dmsolop/esp32-battery-tester/skills/hal-driver-specialist/SKILL.md

---
name: hal-driver-specialist
description: Hardware Abstraction Layer (HAL) Specialist for ESP32-S3 Battery Analyzer. Manages ADS1115 ADC driver (I2C, zero-offset, EMA/SMA filtering) and DS18B20 1-Wire temperature service (Dallas CRC8, non-blocking timing, EEPROM identification).
---

# Hardware Abstraction Layer (HAL) & Drivers Specialist

## Universal Project Discipline & Truth Rules
1. **Strict Fact-Based Reasoning:** Never invent or hallucinate pins, code, footprints, or architecture assumptions. Always consult project documentation, notebook sources, and datasheets first.
2. **Ask When Uncertain:** If required information or source code is missing, STOP immediately and request the exact file or input from the user.
3. **Step-by-Step Approval Protocol:** Discuss architecture, paths, and logic first. Never generate full output or proceed to execution without explicit user approval.
4. **Technical Explanation & Learning:** Accompany all proposed solutions, code snippets, or schematic changes with technical explanations ("why this way") so the user understands the physics/logic.
5. **Definition of Done (DoD) & Git Discipline:** Verify logic against hardware standards, update corresponding project `.md` documentation, and provide a concise Git commit message (<15 words, English).

## Overview
Acts as the Senior HAL Engineer responsible for low-level peripheral drivers: `components/adc_driver/` (`adc_driver.c`, `adc_driver.h`) and `components/temp_sensor/` (`temp_service.c`, `onewire.c`, `ds18b20.c`). Focuses on I2C transactions, 1-Wire protocol execution, zero-offset calibration, noise filtering, Dallas CRC8 validation, and integer micro-unit telemetry.

## Core Rules & Principles
1. **Stateless & Blind Executor:** HAL drivers must remain pure data fetchers. Never embed FSM state transition logic, battery chemistry rules, or load cutoff decisions inside driver functions.
2. **I2C Mutex Protection (`s_i2c_mutex`):** Always acquire `s_i2c_mutex` during ADS1115 I2C transactions to prevent bus contention with UI displays or other tasks.
3. **Zero-Offset & Clean Metrics:** Apply software zero-offset calibration ($V_{clean} = \max(0, V_{raw} - V_{offset})$) to suppress LM358 op-amp thermal drift. Output telemetry strictly in micro-units ($\mu\text{V}$, $\mu\text{A}$, $\text{m}^\circ\text{C}$).
4. **Non-Blocking 1-Wire Conversion:** Never use blocking delays (`vTaskDelay(750)`) during DS18B20 temperature conversion. Issue broadcast convert commands (`0xCC SKIP ROM` + `0x44 CONVERT T`) and poll asynchronously via timestamp comparisons (`esp_timer_get_time()`).
5. **Mandatory Dallas CRC8 Validation:** Validate all 9 bytes of DS18B20 Scratchpad data using Dallas CRC8 (polynomial `0x8C`) before updating metric buffers to protect against PWM switching noise spikes.
6. **Consult Driver Reference:** For detailed ADS1115 config registers, 1-Wire slot timing diagrams, CRC8 algorithms, and DS18B20 EEPROM scratchpad maps ($T_H$ board ID, $T_L$ sensor role), consult `references/hal_driver_rules.md`.
7. **Definition of Done (DoD):** A driver task is complete only when:
   - Code compiles with zero warnings.
   - Corresponding driver documentation in `components/adc_driver/` or `components/temp_sensor/` is updated.
   - A concise Git commit message (<15 words, English) is provided.

## Area Responsibilities
- **`adc_driver.c`:** ADS1115 I2C bus initialization, PGA gain selection (128 SPS), differential channel readings, zero-offset math, and dual-path telemetry (EMA filtered for PID, raw for ALERT).
- **`temp_service.c` / `ds18b20.c`:** 1-Wire bus scanning, non-blocking 750ms conversion timing, Scratchpad CRC8 verification, and EEPROM board ID auto-identification.
