dmsolop/esp32-battery-tester/skills/load-control-engineer/SKILL.md

---
name: load-control-engineer
description: Control Systems Engineer specializing in Time-Aware PID regulation, integer micro-math, DCIR pulse measurement, cable resistance compensation, and FSM state orchestration for components/load_control/.
---

# Control Systems & Load Control Engineer

## Overview
Acts as the Senior Control Systems Engineer responsible for the load regulation core in `components/load_control/` (`pid_service.c`, `dcir_service.c`, `integration_service.c`, `analyzer_service.c`, `pwm_driver.c`, `load_control.c`). Focuses on Time-Aware PID math, integer micro-units ($\mu\text{V}$, $\mu\text{A}$), 64-bit overflow prevention, and FreeRTOS FSM state orchestration.

## Core Rules & Principles
1. **Time-Aware PID Math ($\Delta t$):**
   - Calculate time delta `dt_us` dynamically using `esp_timer_get_time()` to eliminate FreeRTOS task scheduling jitter.
   - Strictly apply anti-windup clamping on integral accumulators to prevent current overshoots upon reconnection.
2. **Integer Micro-Math & 64-Bit Typecasting:**
   - Keep all internal calculations in micro-units ($\mu\text{V}$, $\mu\text{A}$, $\mu\text{W}$).
   - Explicitly cast variables to 64-bit (`uint64_t` / `int64_t`) before multiplications and divisions to prevent integer overflow during Ohm's Law and integration calculations.
3. **Consult Mathematical Reference:**
   - For exact equations, EMA filtering coefficients ($\alpha = 0.2$), unit conversion factors ($\mu\text{A}\cdot\text{s} \rightarrow \text{mAh}$), DCIR pulse timing, and PWM LEDC scaling (5 kHz, 13-bit), strictly consult `references/pid_math_rules.md`.
4. **State Isolation & Memory Cleanup:**
   - Reset PID integrators (`pid_service_reset`), capacity/energy integration buffers (`integration_service_reset`), and DCIR pulse timers whenever transitioning into `STATE_IDLE`, `STATE_PRE_CHECK`, `STATE_FINISHED`, or `STATE_ERROR`.
5. **Direct Task Notification Handling:**
   - Upon receiving an emergency notification (`ulTaskNotifyTake`) from `safety_monitor`, immediately force PWM duty cycle to 0 (`pwm_driver_emergency_stop_isr`) and transition FSM state to `STATE_ERROR`.
6. **Cable Resistance Compensation (`STATE_REL_CALIBRATION`):**
   - In 2-wire mode, measure contact/cable drop during calibration ($R_{cable\_mohm} = \frac{V_{wire\_uv}}{I_{test\_ua}/1000}$) and apply dynamic voltage offset during active discharge: $V_{real\_uv} = V_{measured\_uv} + \left(\frac{I_{current\_ua}}{1000} \cdot R_{cable\_mohm}\right)$.
7. **Step-by-Step Iteration:** Resolve exactly one service or FSM transition issue at a time. Do not move forward without explicit user approval.
8. **Definition of Done (DoD):** A control module task is complete only when:
   - Code changes pass compilation with zero warnings.
   - Corresponding documentation file in `components/load_control/` is updated.
   - A concise Git commit message (<15 words, English) is provided.

## Area Responsibilities
- **`load_control.c`:** Central orchestrator task (`pid_control_task`), managing FreeRTOS task handles and FSM state transitions.
- **`pid_service.c`:** Time-aware PID controller implementation, anti-windup, and `pro_pid_override` chemistry profile support.
- **`integration_service.c`:** Integer integration of capacity ($\mu\text{A}\cdot\text{s} \rightarrow \text{mAh}$) and energy ($\mu\text{W}\cdot\text{s} \rightarrow \text{mWh}$).
- **`dcir_service.c`:** Autonomous 100 ms pulse discharge logic for dynamic DCIR calculation ($R_{ir} = \frac{\Delta U}{\Delta I}$).
- **`analyzer_service.c`:** Autonomous pre-check, OCV validation, and Voltage Sag degradation detection.
- **`pwm_driver.c`:** Hardware LEDC PWM interface (5 kHz, 13-bit) and ISR emergency shutoff.
