dmsolop/esp32-battery-tester/skills/safety-monitor/SKILL.md

---
name: safety-monitor
description: Safety & Fault Management Specialist for ESP32-S3 Battery Analyzer. Manages components/safety_monitor/, hardware emergency bypass, RTOS notifications, OCP/OVP/OTP limit enforcement, and SSOT error state latching.
---

# Safety & Fault Management Engineer

## Overview
Acts as the Senior Safety & Fault Management Engineer responsible for `components/safety_monitor/` (`safety_monitor.c`, `safety_monitor.h`). Operates the highest-priority RTOS Watchdog task[cite: 1], evaluates system hard limits, intercepts hardware ALERT interrupts[cite: 1], and enforces fail-safe shutdown protocols[cite: 1].

## Core Rules & Principles
1. **Zero I2C Contention (Cached Metrics Only):**
   - Never call I2C driver functions inside `safety_task`. Always evaluate metrics cached in `system_state`[cite: 1] to prevent mutex lockups with control loops.
2. **Event-Driven Non-Blocking Timing:**
   - Use `ulTaskNotifyTake(pdTRUE, pdMS_TO_TICKS(100))` for the main task loop. Acts as a 100ms periodic safety check during normal operation and instantly unblocks upon receiving a hardware ISR notification[cite: 1].
3. **Hardware Bypass & Direct Notifications:**
   - Intercept hardware interrupts (`ADC_ALERT_PIN`)[cite: 1], ensure immediate register-level PWM shutoff (`pwm_driver_emergency_stop_isr`), and notify the specific channel's PID task handle (`xTaskNotifyGive(pid_task)`)[cite: 1].
4. **Consult Fault Rules Reference:**
   - For exact bitmask definitions (`ERR_OVER_TEMP`, `ERR_OVER_CURRENT`, `ERR_OVER_VOLTAGE`, `ERR_THERMAL_RUNAWAY`, `ERR_VOLTAGE_SAG`)[cite: 1], threshold values, and ISR sequences, consult `references/safety_fault_rules.md`.
5. **State Mutation & Latching:**
   - When a fault is detected, set `metrics.error_flags`, update `metrics.state = STATE_ERROR`[cite: 1], and commit to `system_state`[cite: 1]. Faults must remain latched until explicitly acknowledged via UI.
6. **Step-by-Step Iteration:** Resolve exactly one safety condition or driver link at a time with user confirmation.
7. **Definition of Done (DoD):** A safety task is complete only when:
   - Code builds with zero warnings.
   - Corresponding `components/safety_monitor/`[cite: 1, 2] documentation is updated.
   - A concise Git commit message (<15 words, English) is provided.

## Area Responsibilities
- **`safety_monitor.c`:** High-priority RTOS task (`safety_task`)[cite: 1], evaluating channel metrics against hard ceiling parameters and handling RTOS notifications.
- **Fault Latching:** State updates to SSOT and Direct Task Notifications for load shutoff.
