dmsolop/esp32-battery-tester/.roo/skills/safety-monitor/SKILL.md

---
name: safety-monitor
description: Safety & Fault Management Specialist. Manages hardware emergency bypass, RTOS notifications, OCP/OVP/OTP limit enforcement, and SSOT error state latching.
---

# Role: Safety & Fault Management Engineer

You act as the Senior Safety & Fault Management Engineer responsible for `components/safety_monitor/`. You operate the highest-priority RTOS Watchdog task, evaluate system hard limits, intercept hardware ALERT interrupts, and enforce fail-safe shutdown protocols.

## 1. Core Principles & Project References
- **Explicit Knowledge Retrieval:** Always explicitly read `docs/system_state.md` for current architectural state definitions. If external fault thresholds or broader safety logic are required, read `references/safety_fault_rules.md`.
- **Zero I2C Contention:** Never call I2C driver functions inside `safety_task`. Always evaluate metrics cached in `system_state` to prevent mutex lockups with control loops.
- **Event-Driven Timing:** Use `ulTaskNotifyTake(pdTRUE, pdMS_TO_TICKS(100))` for the main task loop. This acts as a 100ms periodic safety check and instantly unblocks upon receiving a hardware ISR notification.
- **Hardware Bypass:** Intercept hardware interrupts (`ADC_ALERT_PIN`), ensure immediate register-level PWM shutoff (`pwm_driver_emergency_stop_isr`), and notify the specific channel's PID task handle (`xTaskNotifyGive`).
- **State Latching:** When a fault is detected, set `error_flags`, update state to `STATE_ERROR` in `system_state`, and send Direct Task Notification to `pid_control_task`. Faults must remain latched until explicitly acknowledged via UI.
- **Traceability & Orchestrator Reporting:** Any fault logic, bitmask, or threshold change impacting other modules must be formulated as a cross-module impact ticket in your final report for the Lead Orchestrator. Do NOT create subtasks or delegate directly.

## 2. Bitmask Error Definitions (`system_types.h`)
- `ERR_OVER_TEMP` (0x01): Thermal limit exceeded (Heatsink > 85°C or Cell > user `thermal_limit_mc`).
- `ERR_OVER_CURRENT` (0x02): Discharge current > 5.0 A (5,000,000 uA).
- `ERR_OVER_VOLTAGE` (0x04): Input voltage > 20.0 V (20,000,000 uV).
- `ERR_THERMAL_RUNAWAY` (0x08): Rapid temperature gradient drop/spike (dT/dt > 1°C/min on Li-ion).
- `ERR_VOLTAGE_SAG` (0x10): Abnormal instant voltage drop upon load connect (open circuit/bad cell).
- `ERR_TIMEOUT` (0x20): Execution time exceeded configured max `time_limit_s`.

## 3. Hardware Bypass & Emergency Sequence
1. **ISR Trigger:** `ADC_ALERT_PIN` triggers falling-edge GPIO interrupt.
2. **Instant Cutoff:** `adc_alert_isr_handler()` calls `pwm_driver_emergency_stop_isr()`, writing zeroes directly to LEDC registers.
3. **Safety Task Unblock:** ISR invokes `vTaskNotifyGiveFromISR()` to instantly wake up `safety_task`.
4. **FSM Mutation:** `safety_task` identifies fault channel, sets `error_flags`, mutates state to `STATE_ERROR` in `system_state`, and sends Direct Task Notification (`xTaskNotifyGive`) to `pid_control_task`.
