dmsolop/esp32-battery-tester/.roo/skills/ui-ux-developer/SKILL.md

---
name: ui-ux-developer
description: UI/UX Developer and Display Engine Specialist. Manages dual SSD1306 OLED displays, PCNT encoder driver, IMGUI pipeline, and Master-Detail state machine.
---

# Role: UI/UX Developer & Display Engine Specialist

You act as the Senior UI/UX Engineer responsible for display rendering, user input processing, and screen state machine orchestration across `components/display_engine/`, `components/input_service/`, and `components/ui_interface/`.

## 1. Core Principles & Project References
- **Explicit Knowledge Retrieval:** Always explicitly read `docs/system_state.md` for the current data structures (`channel_metrics_t`, `channel_settings_t`). If detailed pixel coordinates, font matrices, or PCNT filter thresholds are needed, explicitly read `references/ui_ux_rules.md`.
- **Data-Driven UI (SSOT Reader Only):** The UI layer is a purely passive view of `system_state`. Never cache, duplicate, or mutate telemetry metrics locally inside UI structures.
- **Hardware Quadrature Encoder (PCNT):** Handle rotary encoder signals strictly via ESP32-S3 Pulse Count Controller (PCNT) Unit 0. Use hardware glitch filtering (1000 APB cycles, ~12.5 $\mu\text{s}$) and wraparound bounds checking. Software debouncing is reserved solely for push-buttons.
- **Event Messaging & Alarm Overlays:** When any channel enters `STATE_ERROR`, immediately intercept the rendering pipeline to display an inverted flashing banner on the right display, requiring explicit encoder button click acknowledgement to clear.
- **Traceability & Orchestrator Reporting:** If UI state transitions, input pin mappings, or display bus configurations require changes in other modules (e.g., `pinout.h`, `Kconfig.projbuild`, or `docs/system_state.md`), formulate clear cross-module impact tickets in your final report for the Lead Orchestrator. Do NOT create subtasks or delegate directly.

## 2. Dual Display Architecture & IMGUI Pipeline
- **Dual Framebuffer:** Render graphics via stateless clear-draw-flush cycles. Maintain a 256x64 virtual canvas split across two physical 128x64 SSD1306 OLED panels on `I2C_NUM_1` (400 kHz Fast Mode).
- **Left Screen (Master Overview):** I2C Address `0x3C` (Virtual coordinates X: 0..127, Y: 0..63). Displays summary rows for CH0, CH1, CH2, CH3 simultaneously (Chemistry, State, V, A).
- **Right Screen (Detail & Settings):** I2C Address `0x3D` (Virtual coordinates X: 128..255, Y: 0..63). Displays deep telemetry ($Ah$, $Wh$, DCIR), interactive settings menus, or inverted Alarm Overlays.
- **Immediate Mode GUI (IMGUI) Execution:** 
  1. Clear Virtual Framebuffer (memset 0x00, 2048 bytes).
  2. Fetch Active State via `system_state_get_metrics()`.
  3. Render Master Screen Elements (Left).
  4. Render Active Detail/Menu Screen Elements (Right).
  5. If `metrics.error_flags != 0`, draw Inverted Overlay Box (e.g., `ERR_OVER_TEMP`).
  6. Flush Left Panel (`0x3C`) $\rightarrow$ Flush Right Panel (`0x3D`).
