dmsolop/esp32-battery-tester/skills/load-control-engineer/references/pid_math_rules.md

# Control Systems Math & Implementation Rules

## 1. Time-Aware PID Controller Equations
To eliminate FreeRTOS task scheduling jitter (e.g., 100 Hz nominal target vs actual OS tick delays), PID terms must be calculated using exact microsecond deltas (`dt_us = current_time - last_time`):

$$\Delta t_{sec} = \frac{dt\_us}{1000000.0f}$$

- **Error Term:** $e(t) = I_{target\_ua} - I_{measured\_ua}$
- **Proportional Term:** $P = K_p \cdot e(t)$
- **Integral Term with Anti-Windup:**
  $$I_{acc} = I_{acc} + (e(t) \cdot \Delta t_{sec})$$
  $$I_{acc} = \text{clamp}(I_{acc}, -I_{limit}, +I_{limit})$$
  $$I = K_i \cdot I_{acc}$$
- **Derivative Term:**
  $$D = K_d \cdot \frac{e(t) - e(t-1)}{\Delta t_{sec}}$$
- **Output Scaling to 13-Bit PWM (0 – 8191 duty):**
  $$\text{PWM\_Duty} = \text{clamp}\left(\text{round}(P + I + D), 0, 8191\right)$$

## 2. Integer Micro-Math & Overflow Prevention
All internal metric processing operates on integer micro-units ($\mu\text{V}$, $\mu\text{A}$, $\mu\text{W}$). 

### 64-Bit Casting Rules
Always cast intermediate products to 64-bit unsigned/signed integers (`uint64_t` / `int64_t`) before division to prevent integer truncation or overflow:

$$\text{Current Calculation from Shunt:} \quad I_{\mu A} = \left(\text{uint32\_t}\right)\left(\frac{(\text{uint64\_t})V_{shunt\_uv} \cdot 1000000}{R_{shunt\_micro\_ohm}}\right)$$

### Capacity & Energy Numerical Integration
- **Accumulated Charge ($\mu\text{A}\cdot\text{s}$):**
  $$\text{accumulated\_uas} += (\text{uint64\_t})I_{measured\_ua} \cdot \Delta t_{sec}$$
  $$\text{capacity\_mah} = (\text{uint32\_t})\left(\frac{\text{accumulated\_uas}}{3600000}\right)$$
- **Accumulated Energy ($\mu\text{W}\cdot\text{s}$):**
  $$P_{\mu W} = \frac{(\text{uint64\_t})V_{measured\_uv} \cdot I_{measured\_ua}}{1000000}$$
  $$\text{accumulated\_uws} += P_{\mu W} \cdot \Delta t_{sec}$$
  $$\text{energy\_mwh} = (\text{uint32\_t})\left(\frac{\text{accumulated\_uws}}{3600000}\right)$$

## 3. Dynamic DCIR Pulse Math
DCIR is calculated via a periodic 100 ms current pulse:
1. Sample baseline voltage $V_1$ and current $I_1$ in steady state (`STATE_DISCHARGING`).
2. Apply high-current pulse $I_2$ for $100\text{ ms}$.
3. Sample pulse voltage $V_2$ and actual pulse current $I_2$ at $90\text{ ms}$.
4. Calculate internal resistance in micro-ohms ($\mu\Omega$) and store as milliohms ($\text{m}\Omega$):

$$R_{ir\_mohm} = \frac{(V_1 - V_2)_{\mu V} \cdot 1000}{(I_2 - I_1)_{\mu A}}$$

## 4. Exponential Moving Average (EMA) Filtering
- **PID Control Path:** Apply EMA filtering ($\alpha = 0.2$) to raw ADC readings to filter out PWM switching noise:
  $$Y_t = \left(0.2 \cdot X_t\right) + \left(0.8 \cdot Y_{t-1}\right)$$
- **Fast Safety Path:** Pass unfiltered raw ADC readings directly to `safety_monitor` to ensure instant OCP/OVP response without phase delay.

## 5. Hardware LEDC PWM Configuration
- **Frequency:** $5000\text{ Hz}$ (5 kHz).
- **Resolution:** 13-bit ($2^{13} - 1 = 8191$ levels).
- **Emergency Abort:** Immediate clear of LEDC duty register (`ledc_set_duty(..., 0)` followed by `ledc_update_duty(...)`).
