dmsolop/esp32-battery-tester/hardware/Hardware_Design_Log.md

////
Блок вхідного живлення та Native USB-C
Маршрутизація та логіка роботи
Струм іде від кабелю USB-C через пін VBUS і відразу проходить через PTC-запобіжник (який розірве коло, якщо на платі станеться коротке замикання). Далі струм фільтрується від низькочастотних перепадів танталовим конденсатором на 10 мкФ і заходить в лінійний стабілізатор AMS1117-3.3. Він "зрізає" 5V до потрібних 3.3V. На виході танталовий конденсатор на 22 мкФ створює "резервуар" енергії для пікових навантажень Wi-Fi мікроконтролера.
Дані (D+ / D-) йдуть з кабелю прямо у мікросхему USBLC6-2SC6, яка зрізає будь-яку високовольтну статику, і далі йдуть чистими безпосередньо у мікроконтролер.

Інженерне обґрунтування рішень

Резистори 5.1k на CC-лініях: Обов'язкова вимога стандарту USB Power Delivery. Без них сучасні зарядні пристрої вважатимуть роз'єм порожнім, і напруга на VBUS дорівнюватиме 0V.

Native USB: Використання внутрішнього USB PHY контролера ESP32-S3 позбавляє необхідності розводити зовнішню мікросхему UART-моста (наприклад, CH343P) та додаткову обв'язку. Це економить місце на платі та є індустріальним стандартом для Production-пристроїв.

Фільтрація Bulk + Bypass: Тантал має низький ESR (еквівалентний послідовний опір) і відмінно справляється з повільними, але потужними просадками напруги від радіотракту. Кераміка на 100 нФ має низьку індуктивність (ESL) і миттєво гасить високочастотні шуми від цифрових перемикань.

////
Ядро мікроконтролера: ESP32-S3-WROOM-1 та обв'язка завантаження
Маршрутизація та логіка роботи
Головний обчислювальний модуль системи отримує живлення від стабілізованої лінії +3.3V. Для забезпечення стабільного запуску мікроконтролера реалізовано апаратні ланцюги на пінах EN (Enable/Reset) та GPIO0 (BOOT). Лінії даних USB-C (D- та D+) заведені безпосередньо у внутрішній USB PHY контролер модуля (GPIO19, GPIO20) для забезпечення прошивки та JTAG-відладки без застосування зовнішніх мостів типу UART-to-USB.

Інженерне обґрунтування рішень

RC-фільтр на лінії EN: Використовується комбінація підтягуючого резистора (10 кОм) та конденсатора (1 мкФ) до землі. Це створює мікросекундну затримку появи високого рівня на піні EN відносно основного живлення +3.3V, гарантуючи, що внутрішні регістри мікроконтролера встигнуть ініціалізуватися до початку завантаження прошивки.

Підтяжка Strapping-піна GPIO45: У модулі ESP32-S3-WROOM-1 встановлено флеш-пам'ять із робочою напругою 3.3V. Згідно з документацією Espressif, пін GPIO45 (VDD_SPI) під час старту має бути обов'язково підтягнутий до землі (Pull-down) через резистор 10 кОм. Інакше внутрішній регулятор може видати 1.8V, що призведе до неможливості зчитування пам'яті.

Підтяжка Strapping-піна GPIO46: Підтягнуто до землі (10 кОм) для блокування виведення ROM-повідомлень (технічного сміття) у внутрішній UART під час завантаження, що прискорює старт RTOS.

Ізоляція GPIO3: Пін залишено непідключеним (Floating). Це гарантує, що апаратний JTAG маршрутизуватиметься виключно через Native USB-C, звільняючи зовнішні ніжки (зокрема 39, 40, 41) для генерації високочастотного апаратного ШІМ керування силовими транзисторами без конфліктів.

Локальний декоплінг: Безпосередньо біля входу 3V3 модуля встановлено Bulk (10 мкФ) та Bypass (100 нФ) конденсатори для компенсації паразитної індуктивності мідних доріжок від LDO та згладжування струмових сплесків Wi-Fi радіотракту.

////
Блок Інтерфейсу користувача (UI) та I2C
Маршрутизація та логіка роботи
Блок UI винесено на окремий ієрархічний аркуш UI_Controls. Візуалізація даних відбувається через два OLED-дисплеї SSD1306, підключені паралельно до єдиної шини I2C_UI (GPIO6 - SDA, GPIO7 - SCL). Фізичне розділення екранів (Master/Detail) реалізується апаратною перемичкою адреси 0x78/0x7A на платі одного з модулів. Уведення здійснюється через ротаційний енкодер (GPIO15, 16, 17) та окрему кнопку тарування (GPIO18). Зв'язок між аркушами схеми реалізовано через Global Labels.

Інженерне обґрунтування рішень

Підтяжки I2C (Pull-up): Інтерфейс I2C має архітектуру відкритого стоку (Open-Drain). На лінії SDA та SCL встановлено резистори 4.7 кОм до +3.3V. Це гарантує швидкий фронт наростання сигналу (Rise Time) та стабільну роботу на частоті 400 кГц (Fast Mode) навіть при наявності двох дисплеїв на шині.

Гібридний антидебаунс енкодера: Механічний брязкіт контактів енкодера нівелюється комбінованим підходом. Апаратний шар — RC-фільтр (підтяжка 10 кОм та конденсатор 10 нФ на землю) згладжує найгостріші високовольтні спайки (глітчі). Програмний шар — вбудована периферія PCNT мікроконтролера ESP32-S3 ідеально підраховує вже згладжені імпульси без витрачання процесорного часу.

Рівні RTC-домену: Усі органи керування (енкодер та кнопка) маршрутизовані виключно на піни домену RTC мікроконтролера (15-18). Це закладає архітектурну можливість переведення пристрою в режим Deep Sleep з пробудженням за апаратним перериванням від обертання ручки.

////
Порти силових модулів (Master-to-Slave) та Маршрутизація
Маршрутизація та логіка роботи Взаємодія між керуючою материнською платою та силовими модулями реалізована за модульною топологією "Зірка" через 4 незалежні порти на базі роз'ємів RJ45. Для з'єднання використовується стандартна вита пара (Ethernet Cat5e/Cat6, 8 жил). Кожен порт передає як спільні шини (Живлення +3.3V, I2C для ADS1115, лінія переривань ADC_ALERT), так і унікальні для кожного каналу керуючі сигнали (високочастотний ШІМ-сигнал та лінія 1-Wire для апаратної ідентифікації температурних датчиків).
Інженерне обґрунтування рішень
RJ45 та Вита Пара: Використання витої пари дозволяє кардинально знизити перехресні наведення (Crosstalk) між каналами та вплив електромагнітного шуму (EMI) від струмів у 30 А. Сигнал ШІМ конструктивно спарюється в одному витку із земляним провідником (GND) для мінімізації площі струмової петлі та паразитних випромінювань.
Підтяжка лінії ADC_ALERT (Монтажне АБО): Піни ALERT усіх чотирьох АЦП на Slave-платах з'єднані паралельно на одну Глобальну лінію. Вона має архітектуру відкритого стоку (Open-Drain) і підтягнута на Master-платі єдиним резистором 10 кОм до +3.3V. Будь-який з АЦП може притиснути цю лінію до землі у разі аварії, викликаючи миттєве апаратне переривання на GPIO 47.
Апаратне розгалуження 1-Wire: Згідно з технічним завданням, для забезпечення принципу "Plug & Play" та уникнення теплової розсинхронізації, шина 1-Wire фізично розділена. Кожен слот має свій виділений GPIO (8-11) та власну апаратну підтяжку шини резистором 4.7 кОм на стороні Master-плати, що відповідає специфікації Dallas Semiconductor.
Передача ШІМ без фільтрації: На боці Master-плати ШІМ-сигнали (5 кГц) виводяться на роз'єми у вигляді жорсткого цифрового меандру без інтегруючих ланцюгів. Це запобігає спотворенню аналогової опорної напруги на опорі з'єднувального кабелю; RC-фільтрація відбуватиметься безпосередньо біля операційних підсилювачів на Slave-платах.
Гальванічне розділення шин I2C: Архітектура передбачає дві фізично незалежні шини I2C. Повільна "візуальна" шина (I2C_UI на GPIO 6, 7) обслуговує лише екрани. Критична "силова" шина (I2C_PWR на GPIO 4, 5) виділена виключно для АЦП ADS1115. Це фундаментально унеможливлює ситуацію, коли відмальовка графіки на екрані викликає транспортну затримку та блокує жорсткий 10-мілісекундний цикл ПІД-регулятора.

///
### Порти силових модулів (Master-to-Slave) та Маршрутизація

**Топологія та Кабельна інфраструктура (S/FTP)**
Взаємодія між керуючою материнською платою та 4 силовими модулями реалізована за топологією "Зірка". Як фізичний рівень використовуються екрановані роз'єми RJ45 (Shielded) та кабелі витої пари стандарту S/FTP. Механічні екрани роз'ємів впаяні безпосередньо в полігон GND на обох платах. Екран кабелю утворює "клітку Фарадея", що надійно захищає цифрові шини від імпульсних магнітних наведень (EMI) при комутації струмів до 30 А, а також слугує масивним еталонним провідником для вирівнювання потенціалів земель Master та Slave.

**Оптимізована розпіновка (стандарт T568B)**
Для збереження цілісності сигналів (Signal Integrity) маршрутизація портів жорстко прив'язана до фізичного скручування пар у кабелі T568B:
*   **Пара 1 (Піни 1, 2): `PWM_CHx` / `GND`.** Жорсткий високочастотний ШІМ-сигнал спарений із власним зворотним шляхом. Це мінімізує площу струмової петлі та запобігає випромінюванню завад на інші лінії.
*   **Пара 2 (Піни 3, 6): `+3.3V` / `FAN_CHx`.** "Брудний" ШІМ-сигнал керування вентиляторами охолодження спарений із жорсткою лінією живлення, яка поглинає ємнісні наведення завдяки низькому імпедансу.
*   **Пара 3 (Піни 4, 5): `I2C_PWR_SDA` / `I2C_PWR_SCL`.** Виділена силова шина I2C.
*   **Пара 4 (Піни 7, 8): `ADC_ALERT` / `1W_CHx`.** Сусідство низькоактивних сигналів. ALERT підтягнутий до високого рівня і спрацьовує лише в аварійних ситуаціях, що гарантує відсутність перехресних завад (Crosstalk) для шини 1-Wire.

**Гальванічне розділення шин I2C**
Архітектура передбачає дві фізично незалежні шини I2C. Повільна "візуальна" шина (`I2C_UI` на GPIO 6, 7) обслуговує виключно OLED-екрани. Критична "силова" шина (`I2C_PWR` на GPIO 4, 5) виділена виключно для опитування АЦП ADS1115 на Slave-платах. Це фундаментально унеможливлює ситуацію, коли відмальовка графіки блокує жорсткий цикл ПІД-регулятора. Силова шина має власні підтягуючі резистори 4.7 кОм на стороні Master-плати.

**Керування охолодженням та Термічна симетрія**
На кожному силовому модулі розташовано два вентилятори (кулери). Керування ними здійснюється синхронно єдиним ШІМ-сигналом `FAN_CHx` (GPIO 12, 13, 14, 21), оскільки обидва транзистори працюють у спільній тепловідвідній зоні і розсіюють однакову потужність завдяки двом незалежним петлям зворотного зв'язку на LM358. Програмний алгоритм обирає найвищу температуру з двох датчиків 1-Wire на модулі і пропорційно керує обома кулерами через один N-канальний MOSFET на Slave-платі.

**Лінія апаратного переривання (ADC_ALERT)**
Піни ALERT усіх чотирьох АЦП на силових платах з'єднані паралельно (Монтажне АБО) та підтягнуті єдиним резистором 10 кОм до +3.3V на Master-платі. Це забезпечує миттєве апаратне переривання на GPIO 47 мікроконтролера у разі виявлення критичного струму або напруги будь-яким з АЦП.

////
## [2026-10-11] Силовий каскад Slave-модуля (Power Stage) — Завершено

Сьогодні було спроєктовано та повністю розведено силове ядро плати електронного навантаження (аркуш `Power_Stage`). Схема базується на двох паралельних каналах з використанням N-канальних потужних MOSFET IRFP250N (корпус TO-247), якими керує здвоєний операційний підсилювач LM358 у лінійному режимі. Плата розрахована на тривале розсіювання потужності при струмах до 30А та напругах до 60В.

### Детальне обґрунтування архітектурних рішень:

#### 1. Ізоляція контурів: Топологія "Зіркової землі" (Star Ground)
Під час комутації струмів у десятки ампер опір самих мідних доріжок плати стає значним. Якщо аналогова і силова землі будуть об'єднані хаотично, струм навантаження створить падіння напруги на загальній землі (Ground Bounce), що повністю спотворить покази АЦП та роботу ОП. 
**Рішення:** Застосовано віртуальний компонент `Net Tie` для фізичного розділення силового контуру (`GND_PWR`) та надчистого аналогового контуру (`GND`). Увесь струм від шунтів стікає в `GND_PWR` і ніколи не перетинає полігони керування. `Net Tie` з'єднує ці дві землі лише в одній еталонній точці, гарантуючи ідеальний "нуль" для вимірювань.

#### 2. Запобігання автогенерації: Інтегратор замість компаратора
Затвор транзистора IRFP250N має величезну паразитну ємність (C_iss ≈ 2000 пФ). При спробі LM358 різко змінити струм, ця ємність створює затримку реакції (зсув фази). Без компенсації ОП почне "перерегульовувати" сигнал, і схема увійде в жорсткий режим високочастотної автогенерації (сотні кілогерц), що призведе до миттєвого теплового пробою MOSFET.
**Рішення:** ОП переведено в режим інтегратора. Між витоком транзистора та інвертуючим входом ОП встановлено ізолюючий резистор 1 кОм, а між виходом ОП та інвертуючим входом — керамічний конденсатор 1 нФ. Цей RC-ланцюг загладжує реакцію підсилювача на мікросекундні сплески, забезпечуючи плавне та стабільне відкриття транзистора без осциляцій.

#### 3. Абсолютний захист Затвора (Gate-Source Zener Protection)
Максимально допустима напруга між Затвором і Витоком ($V_{GS}$) для IRFP250N становить ±20В. Будь-який стрибок вище цього значення проб'є оксидний шар і знищить кристали. 
**Рішення:** Встановлено стабілітрони BZT52C15 (15V, 500mW) паралельно переходу Затвор-Витік кожного транзистора. 
*Критичний нюанс розведення:* Анод стабілітрона підключено суворо до Витоку (Source, пін 3), а не до Стоку (Drain, пін 2, куди підключено високовольтне навантаження). Витік є безпечною точкою, оскільки напруга на ньому визначається лише падінням на шунтах (максимум ~165 мВ при 15А). Це гарантує, що стабілітрон зрізатиме лише небезпечні потенціали, згенеровані ємністю Міллера або помилками ОП, не пропускаючи при цьому високу напругу акумулятора, що тестується.

#### 4. Захист від індуктивних викидів
* На загальному силовому вході встановлено однонаправлений TVS-діод SMCJ58A (1500 Вт імпульсної потужності). Він захищає схему від зворотного ЕРС при тестуванні збірок із довгою проводкою. Катод діода спрямований до плюса навантаження.
* Паралельно кожному транзистору (між Drain та Source) додано RC-снабер (плівковий конденсатор 100 нФ + резистор 10 Ом) для придушення високочастотного "дзвону".

#### 5. Кельвінівська 4-дротова схема (Kelvin Sensing)
Для усунення похибок вимірювання напруги через падіння на силових терміналах, напруга зчитується окремими лініями `LOAD_SENSE_+` та `LOAD_SENSE_-`, які йдуть паралельно силовим `LOAD_FORCE_+` / `LOAD_FORCE_-` і не несуть струму. Струм кожного транзистора зчитується через окремі мітки `I_SENSE_Q1` / `I_SENSE_Q2` безпосередньо з витоків транзисторів (до Net Tie).

Схема повністю верифікована та готова до інтеграції цифрового керування (аркуш Telemetry).

////
## [2026-10-13] Телеметрія та вимірювальне коло (Telemetry) — Завершено

Сьогодні було завершено розробку аркуша `Telemetry`, який відповідає за прецизійне оцифрування аналогових сигналів на Slave-модулі.

### Ключові схемотехнічні рішення:

#### 1. АЦП та магістраль зв'язку
Серцем вимірювальної системи обрано 16-бітний АЦП **ADS1115IDGS** (Texas Instruments) у корпусі VSSOP-10. Він розпаюється безпосередньо на платі для мінімізації EMI та перехідних опорів. Зв'язок із Master-платою відбувається по шині I2C через екранований патчкорд (RJ45).

#### 2. Апаратна адресація (I2C)
Для можливості паралельної роботи 4 однакових модулів на одній шині I2C реалізовано апаратний селектор адреси. Використано дворядно-штировий роз'єм `PinHeader_2x04`. Замиканням стандартного джампера користувач може підключити пін `ADDR` до однієї з чотирьох ліній (`GND`, `+3.3V`, `SDA`, `SCL`), що задає модулю одну з чотирьох унікальних I2C-адрес (від `0x48` до `0x4B`) без ризику короткого замикання.

#### 3. Диференційний дільник напруги (1:20)
Для безпечного вимірювання напруги до 60V застосовано прецизійний резистивний дільник 1:20 (190k / 1206 та 10k / 0805, 0.1%, 25ppm/C).
*   **Схема Кельвіна:** Середня точка дільника підключена до входу `AIN2`, а нижнє плече (10k) опирається не на локальну `GND`, а на виділену лінію `LOAD_SENSE_-`, яка йде від клеми акумулятора і підключена до `AIN3`. 
*   Вимірювання відбувається в диференційному режимі (`AIN2` - `AIN3`). Це гарантує повне відсікання синфазних завад і падінь напруги на силових кабелях.
*   Додано керамічний конденсатор 100nF паралельно нижньому плечу для апаратної LPF-фільтрації наведень.

#### 4. Захист лінії переривання (ADC_ALERT)
Лінія `ALERT/RDY` використовується для екстреного апаратного відключення при перевантаженнях. Щоб уникнути хибних спрацьовувань від жорсткого ШІМ-наведення (EMI) силового каскаду, на Slave-модулі встановлено керамічний конденсатор 1nF безпосередньо біля піна АЦП на землю. Підтяжка (Pull-up) лінії реалізується централізовано на Master-платі.

////
## [2026-10-13] Захист Master-плати та цифрових інтерфейсів (Hardware Protection)

Сьогодні було спроєктовано ешелонований апаратний захист Master-плати від потрапляння високої напруги (до 60В) через роз'єми RJ45 у випадку критичного пробою на Slave-модулях. Архітектуру захисту розроблено з урахуванням абсолютних максимальних рейтингів мікроконтролера ESP32-S3 (Absolute Maximum VDD/VIN = 3.6V).

### Ключові схемотехнічні рішення:

#### 1. Захист шини живлення (+3.3V) — "Crowbar" (Лом)
Для захисту лінійного стабілізатора та мікроконтролера від зворотної інжекції 60В застосовано зв'язку PTC + TVS:
*   **PTC Polyfuse (200mA, 60V):** Встановлено у розрив лінії +3.3V (корпус 1206 для забезпечення високовольтного зазору, тип Bourns MF-NSMF020/60).
*   **TVS-діод (SMBJ3V3):** Однонаправлений клампер на 600 Вт. Встановлено після запобіжника паралельно до землі. У разі аварії діод миттєво закорочує 60В на землю, фіксуючи напругу на рівні ~3.6В, а надструм короткого замикання за мілісекунди розігріває та розриває PTC-запобіжник.

#### 2. Захист сигнальних ліній (I2C, FAN_PWM, ADC_ALERT)
Для кожної цифрової лінії застосовано дворівневий захист (Струмообмеження + Клампінг Шотткі):
*   **Струмообмеження:** У розрив кожної лінії (з боку RJ45) встановлено резистор **100 Ом** (SMD 0805). При потраплянні 60В він жорстко обмежує аварійний струм до безпечних ~600 мА.
*   **Жорсткий клампінг (BAT54S):** Оскільки стандартні 5В TVS-збірки (на кшталт SRV05-4) допускають стрибок напруги до 4.5В (що перевищує ліміт ESP32-S3), застосовано здвоєні діоди Шотткі BAT54S (SOT-23). Аварійний струм скидається на шину +3.3V. Завдяки низькому прямому падінню напруги на діоді Шотткі ($V_F \approx 0.3V$), напруга на піні мікроконтролера фізично обмежується еталонним максимумом: `3.3V + 0.3V = 3.6V`.

Це гарантує 100% виживання дорогої керуючої логіки при катастрофічних руйнуваннях силової частини.

////
## [2026-10-14] Master Board: Footprints & Schematic Finalization

**Module:** Master Board (`battery_analyzer_hw`)
**Status:** Прив'язка посадкових місць завершена. Схема готова. Перехід до Slave-модуля.

**Виконані роботи та прийняті рішення (Changes & Decisions):**
*   **Footprint Audit:** Виявлено та виправлено некоректні посадкові місця (наприклад, SOIC-8 для конденсаторів). Заповнено всі порожні поля компонентів на аркушах `/MCU_Core/`, `/UI_Controls/`, `/Slave_Ports/`.
*   **HandSolder Policy:** Застосовано правило використання подовжених контактних площадок (`_HandSolder` / `_Handsoldering`) для всіх SMD-резисторів (0805), керамічних конденсаторів (0805, 1206), PTC-запобіжників (1206) та TVS/Шотткі діодів (SOT-23, SMB) для спрощення ручного паяння.
*   **Tantalum Capacitors:** Виправлено архітектурну помилку — поляризовані конденсатори C1 (10uF), C3 (22uF) та C6 (10uF) переведено на танталові SMD-корпуси (Type A та Type B).
*   **UI Controls:** Призначено точні посадкові місця під наявне залізо: вивідні тактові кнопки 6x6 мм (THT 4-pin) та механічний енкодер ALPS EC12E (12x12 мм).
*   **UI Fascia Separation (План):** Затверджено концепцію винесення UI (енкодер, дисплей, кнопка TARE) на передню панель корпусу. Фізичні компоненти SW3 та SW4 на платі будуть замінені на надійні конектори (напр. JST-XH). RC-фільтри (C8-C11) залишаються на Master-платі.
*   **KY-040 Mod:** Оскільки модуль енкодера має власні підтягуючі резистори на 10 кОм, резистори R9, R10, R11 на головній платі будуть видалені для уникнення падіння загального опору.

////
## [2026-10-14] Slave Board: Footprints & BOM Audit

**Module:** Slave Board (`slave_board`)
**Status:** Прив'язка посадкових місць завершена. Схема готова.

**Виконані роботи та прийняті рішення (Changes & Decisions):**
*   **HandSolder Policy:** Усі пасивні SMD-компоненти (конденсатори C1-C9, резистори R1-R4, R11-R16) переведено на корпуси 0805/1206 із суфіксом `_HandSolder`.
*   **BOM Correction:** Виправлено критичні помилки призначення посадкових місць (плівкові конденсатори в діодних корпусах, 10-омні резистори в корпусах TO-247, NetTie у вигляді RF-модуля).
*   **Precision Shunts:** Затверджено корпус 2512 для струмовимірювальних шунтів (R5-R10) для забезпечення необхідного розсіювання потужності.
*   **Connector Policy:** Прийнято рішення залишити посадкові місця для всіх роз'ємів (J1, J3, J5) невизначеними. Їхній фінальний вибір та прив'язка відбудуться на етапі закупівлі комплектуючих безпосередньо перед розведенням PCB.

////
[2026-10-16] Slave Board: Thermal Management & Connectivity Update
Module: Slave Board (slave_board, cooling_thermal)
Status: Додано новий функціонал охолодження та телеметрії, оновлено роз'єми, налаштовано глобальні зв'язки.

Виконані роботи та прийняті рішення (Changes & Decisions):

Cooling & Thermal Module: Створено новий ієрархічний аркуш /cooling_thermal/ для керування температурним режимом плати.

Temperature Sensors: Додано два 1-Wire цифрових датчики температури DS18B20 (U3, U4) для моніторингу нагріву ключових вузлів.

Fan Control Logic: Реалізовано схему керування двома 12V вентиляторами (J_FAN1, J_FAN2) за допомогою ШІМ через N-канальний MOSFET IRLML2502 (Q_FAN1). Встановлено захисний діод 1N4148W (D2) та резистор на 10k (R17). Розпіновку роз'ємів приведено до стандарту (Пін 1: керована GND, Пін 2: +12V, Пін 3: NC).

Power & I/O Connectors: На кореневий аркуш додано силовий вхідний роз'єм XT60PW-M (J_PWR1) та захисний SMD-запобіжник F1 на 25A. Також інтегровано надійні роз'єми Micro-Fit 3.0 для вимірювальних ліній (J_SENSE1) та підключення зовнішньої телеметрії (J_TEMP1).

Precision Shunts Correction: Виправлено номінали струмовимірювальних шунтів (R5-R10) у блоці Power Stage на коректне значення 0.033 Ом.

Global Connectivity Refactoring: Адаптовано схему під особливості KiCad 10. Локальні ієрархічні мітки замінено на спеціалізовані глобальні символи живлення (+12V, +3.3V, GND, GND_PWR) та глобальні мітки для керівних сигналів (FAN_PWM, 1W_DATA), що забезпечило надійний наскрізний зв'язок між усіма аркушами плати.

////
[ЛОГ ПРОЄКТУ - Листопад 2026]
Завдання: Синхронізація I2C-шин та верифікація таблиць зв'язків (Netlists) для макетування.

Статус майстер-плати (battery_analyzer_hw): 
- Успішно. Піни мікроконтролера ESP32-S3 (U3) перевірено та синхронізовано з прошивкою ESP-IDF:
  - `I2C_PWR_SDA` = `IO4` (U3 пін 4), `I2C_PWR_SCL` = `IO5` (U3 пін 5).
  - `I2C_UI_SDA` = `IO6` (U3 пін 6), `I2C_UI_SCL` = `IO7` (U3 пін 7).
- Підтяжки 4.7 кОм та захисні діодні збірки BAT54S підключені коректно.

Статус підлеглої плати (slave_board): 
- Успішно верифіковано нетліст `slave_board.net`.
- `PWM_IN` коректно з'єднує вхід RJ45 (J1 пін 1) з входом RC-фільтра ШІМ (R1 пін 1).
- `LOAD_FORCE_+` надійно з'єднує XT60 (J_PWR1 пін 1 через запобіжник F1), стоки MOSFET Q1/Q2, снабери C3/C4 та катод захисного TVS SMCJ58A (D1).
- `GND_PWR` (`LOAD_FORCE_-`) з'єднує XT60 (J_PWR1 пін 2), нижні виводи шунтів R5-R10, анод TVS D1 та NetTie NT1 до сигнальної GND.
- Вимірювальні лінії Кельвіна `LOAD_SENSE_+` та `LOAD_SENSE_-` виведені на окремий конектор Micro-Fit 3.0 (J_SENSE1) та підключені до диференційного дільника напруги (R15 190k, R16 10k, C9 100nF) на входах AIN2/AIN3 АЦП U2 ADS1115.
- Струмові сенсорні точки `I_SENSE_Q1` та `I_SENSE_Q2` зняті безпосередньо з витоків транзисторів і підключені до AIN0 та AIN1 АЦП U2 ADS1115.
- Всі ланцюги готові до збирання лабораторного макету.

////
[ЛОГ ПРОЄКТУ - Листопад 2026]
Завдання: Уніфікація глобального пінауту ESP32-S3 (Варіант Б) для DevKitC-1 сумісності та усунення WPU-глічів.

Статус майстер-плати (battery_analyzer_hw) та прошивки:
- Проведено аудит початкового стану пінів мікроконтролера ESP32-S3 при апаратному скиданні (Reset / Boot):
  - Піни `IO39` та `IO41` мають внутрішнє апаратне слабке підтягування до VDD33 (`Internal Weak Pull-Up`), що створювало небезпеку паразитного привідкривання силових MOSFET у каналах CH1 та CH3 до ініціалізації прошивки.
  - Пін `IO48` на платах `ESP32-S3-DevKitC-1` жорстко задіяний під адресований світлодіод WS2812.
- Затверджено та синхронізовано уніфікований розподіл сигналів (Варіант Б):
  - **Силовий ШІМ навантаження (`PWM_CH0..3`):**
    - `PWM_CH0` = `IO38` (Hi-Z при скиданні)
    - `PWM_CH1` = `IO1` (Hi-Z при скиданні, перенесено з `IO39`)
    - `PWM_CH2` = `IO40` (Hi-Z при скиданні)
    - `PWM_CH3` = `IO2` (Hi-Z при скиданні, перенесено з `IO41`)
    Всі 4 силові канали тепер гарантовано захищені від імпульсного привідкривання транзисторів при скиданні МК.
  - **ШІМ охолодження (`FAN_CH0..3`):**
    - `FAN_CH0` = `IO12`
    - `FAN_CH1` = `IO13` (звільняє `IO48`)
    - `FAN_CH2` = `IO14`
    - `FAN_CH3` = `IO21`
  - **Звукова індикація (`BUZZER_PIN`):**
    - `BUZZER` = `IO42` із зовнішнім резистором підтяжки до землі `4.7 kOhm` (R36 на GND) для захисту від глітчів під час завантаження/скидання МК.
  - **Звільнені піни:** `IO39`, `IO41` (залишені як резервні NC), `IO48` (RGB LED на DevKit).
- Синхронізовано `main/Kconfig.projbuild`, `sdkconfig` та архітектурну документацію.
- Експортовано та повністю верифіковано оновлений нетліст `battery_analyzer_hw.net`: усі ланцюги U3 (ESP32-S3-WROOM-1) 100% відповідають затвердженому уніфікованому пінауту Варіанта Б.
