dmsolop/esp32-battery-tester/hardware/battery_analyzer_hw/battery_analyzer_hw.kicad_sch

## KiCad design hardware/battery_analyzer_hw/battery_analyzer_hw.kicad_sch (2026-10-15)

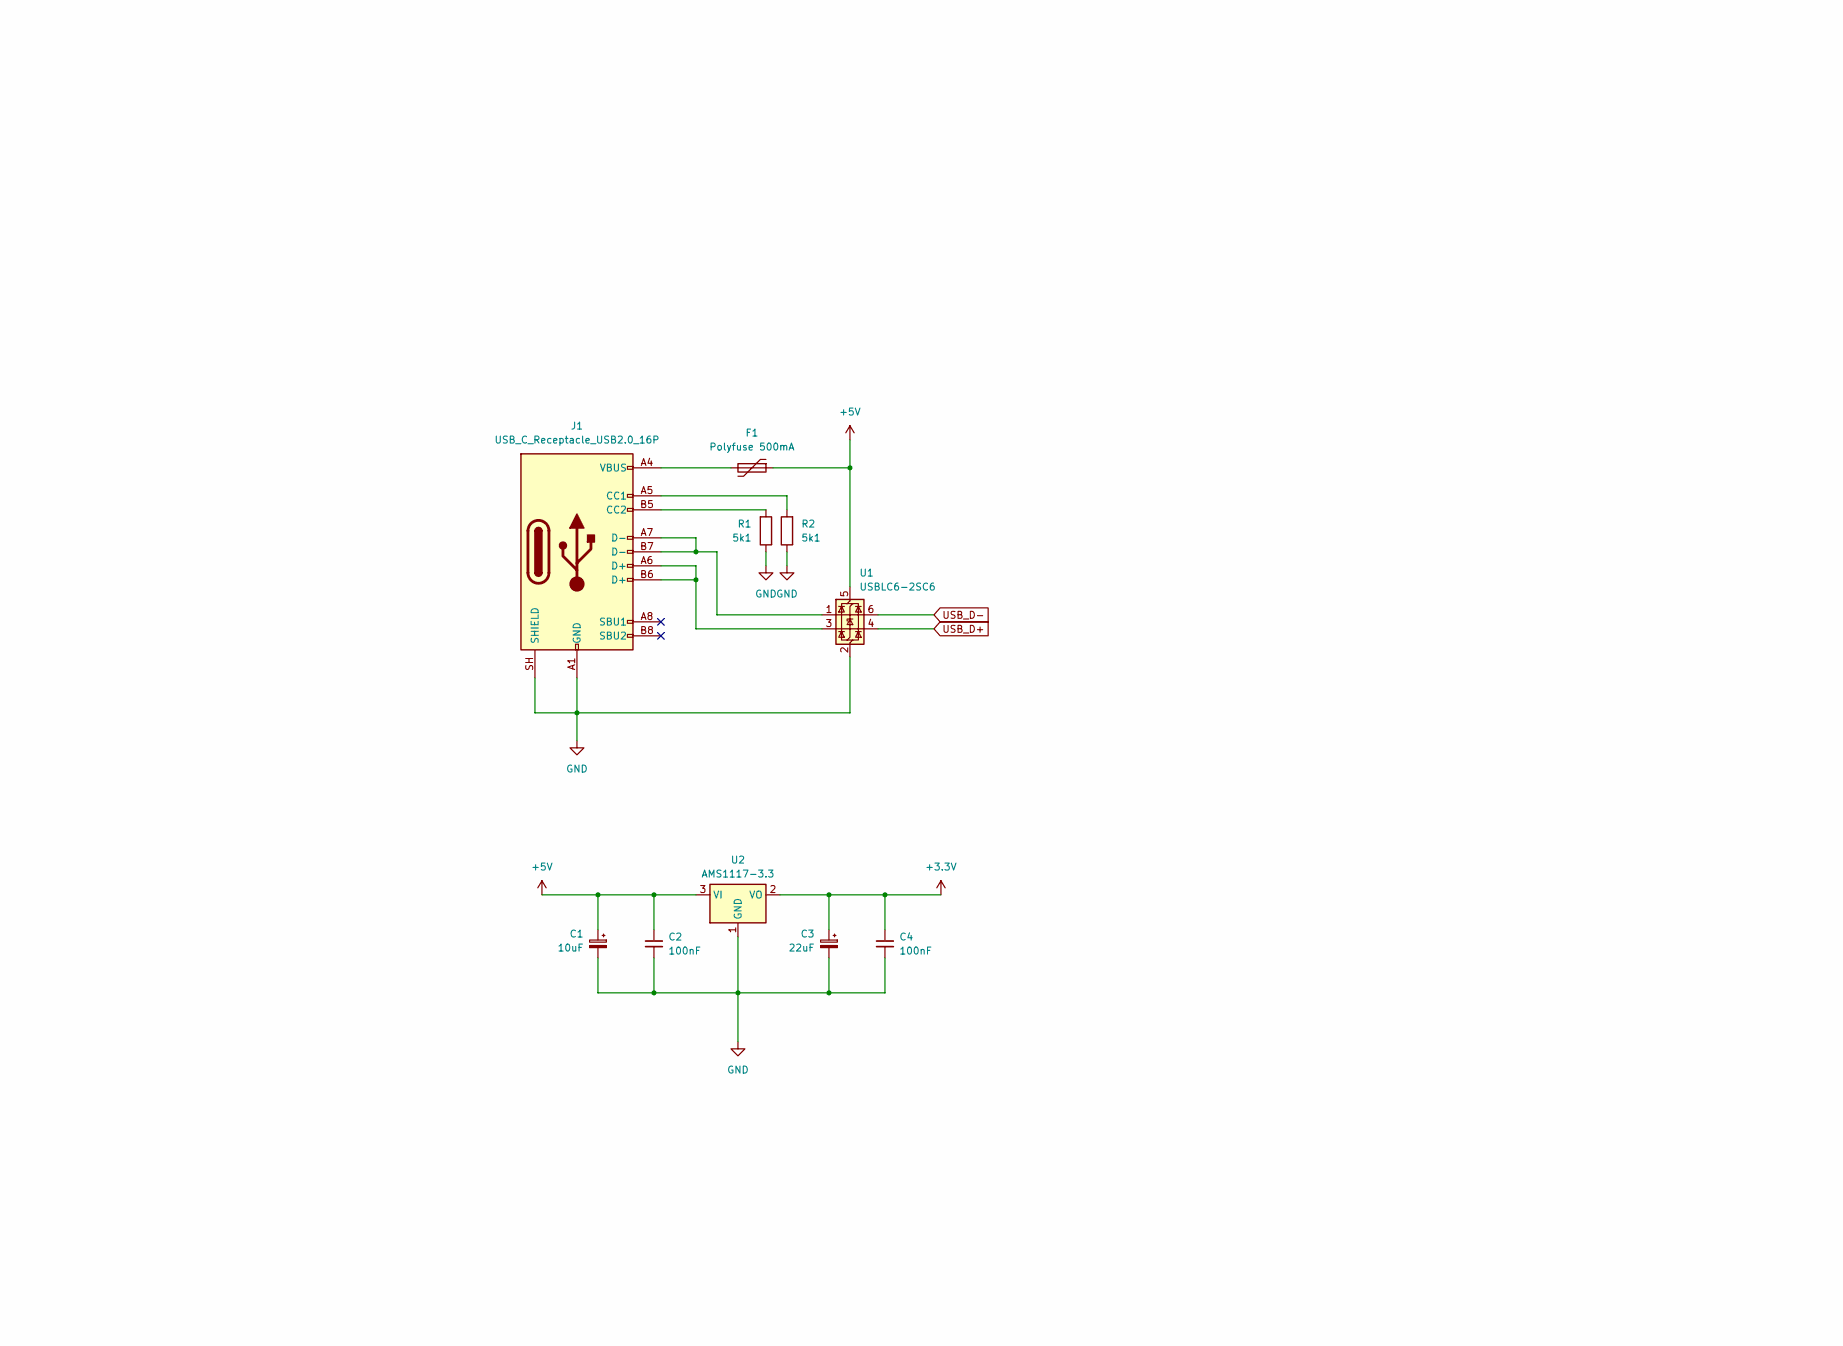
[picture p1: schematic battery_analyzer_hw.kicad_sch, part in row 2, column 1]

Parts:
C1: 10uF; CP_EIA-3216-18_Kemet-A_HandSolder
C2, C4: 100nF; C_0805_2012Metric_Pad1.18x1.45mm_HandSolder
C3: 22uF; CP_EIA-3528-21_Kemet-B_HandSolder
F1: Polyfuse 500mA; Fuse_1206_3216Metric_Pad1.42x1.75mm_HandSolder
J1: USB_C_Receptacle_USB2.0_16P; USB_C_Receptacle_HRO_TYPE-C-31-M-12
R1, R2: 5k1; R_0805_2012Metric_Pad1.20x1.40mm_HandSolder
U1: USBLC6-2SC6; SOT-23-6_Handsoldering
U2: AMS1117-3.3; SOT-223-3_TabPin2

Connections:
+3.3V: C3.1, C4.1, U2.2 (VO)
+5V: C1.1, C2.1, F1.1, U1.5 (VBUS), U2.3 (VI)
GND: C1.2, C2.2, C3.2, C4.2, J1.A1 (GND), J1.A12 (GND), J1.B1 (GND), J1.B12 (GND), J1.SH (SHIELD), R1.1, R2.1, U1.2 (GND), U2.1 (GND)
unnamed: F1.2, J1.A4 (VBUS), J1.A9 (VBUS), J1.B4 (VBUS), J1.B9 (VBUS)
unnamed: J1.A5 (CC1), R2.2
unnamed: J1.A6 (D+), J1.B6 (D+), U1.3 (I/O2)
unnamed: J1.A7 (D-), J1.B7 (D-), U1.1 (I/O1)
unnamed: J1.B5 (CC2), R1.2
USB_D+: U1.4 (I/O2)
USB_D-: U1.6 (I/O1)
