dmsolop/esp32-battery-tester/hardware/battery_analyzer_hw/mcu_core.kicad_sch

## KiCad design hardware/battery_analyzer_hw/mcu_core.kicad_sch (2026-11-13, an earlier design)

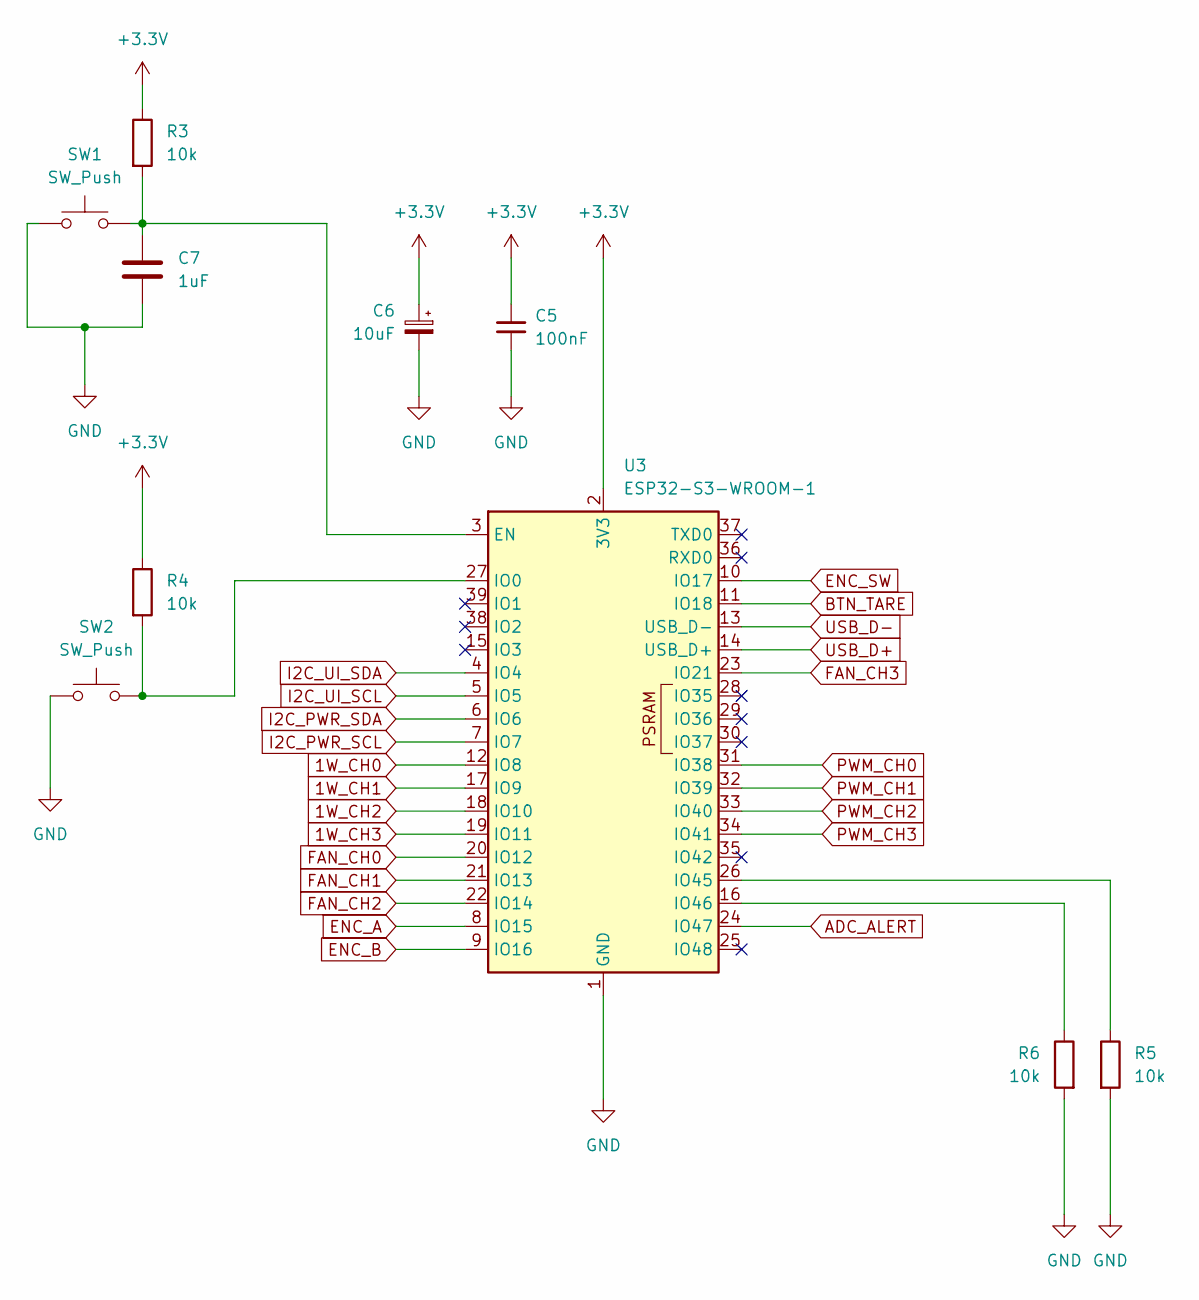
[picture p2: schematic mcu_core.kicad_sch]

Parts:
C5: 100nF; C_0805_2012Metric_Pad1.18x1.45mm_HandSolder
C6: 10uF; CP_EIA-3216-18_Kemet-A_HandSolder
C7: 1uF; C_0805_2012Metric_Pad1.18x1.45mm_HandSolder
R3, R4, R5, R6: 10k; R_0805_2012Metric_Pad1.20x1.40mm_HandSolder
SW1, SW2: SW_Push; SW_PUSH_6mm
U3: ESP32-S3-WROOM-1

Connections:
1W_CH0: U3.12 (IO8)
1W_CH1: U3.17 (IO9)
1W_CH2: U3.18 (IO10)
1W_CH3: U3.19 (IO11)
+3.3V: C5.1, C6.1, R3.1, R4.1, U3.2 (3V3)
ADC_ALERT: U3.24 (IO47)
BTN_TARE: U3.11 (IO18)
ENC_A: U3.8 (IO15)
ENC_B: U3.9 (IO16)
ENC_SW: U3.10 (IO17)
FAN_CH0: U3.20 (IO12)
FAN_CH1: U3.21 (IO13)
FAN_CH2: U3.22 (IO14)
FAN_CH3: U3.23 (IO21)
GND: C5.2, C6.2, C7.2, R5.2, R6.2, SW1.1, SW2.1, U3.1 (GND), U3.40 (GND), U3.41 (GND)
I2C_PWR_SCL: U3.7 (IO7)
I2C_PWR_SDA: U3.6 (IO6)
I2C_UI_SCL: U3.5 (IO5)
I2C_UI_SDA: U3.4 (IO4)
unnamed: C7.1, R3.2, SW1.2, U3.3 (EN)
unnamed: R4.2, SW2.2, U3.27 (IO0)
unnamed: R5.1, U3.26 (IO45)
unnamed: R6.1, U3.16 (IO46)
PWM_CH0: U3.31 (IO38)
PWM_CH1: U3.32 (IO39)
PWM_CH2: U3.33 (IO40)
PWM_CH3: U3.34 (IO41)
USB_D+: U3.14 (USB_D+)
USB_D-: U3.13 (USB_D-)
