dmsolop/esp32-battery-tester/hardware/battery_analyzer_hw/slave_ports.kicad_sch

## KiCad design hardware/battery_analyzer_hw/slave_ports.kicad_sch (2026-11-13, an earlier design)

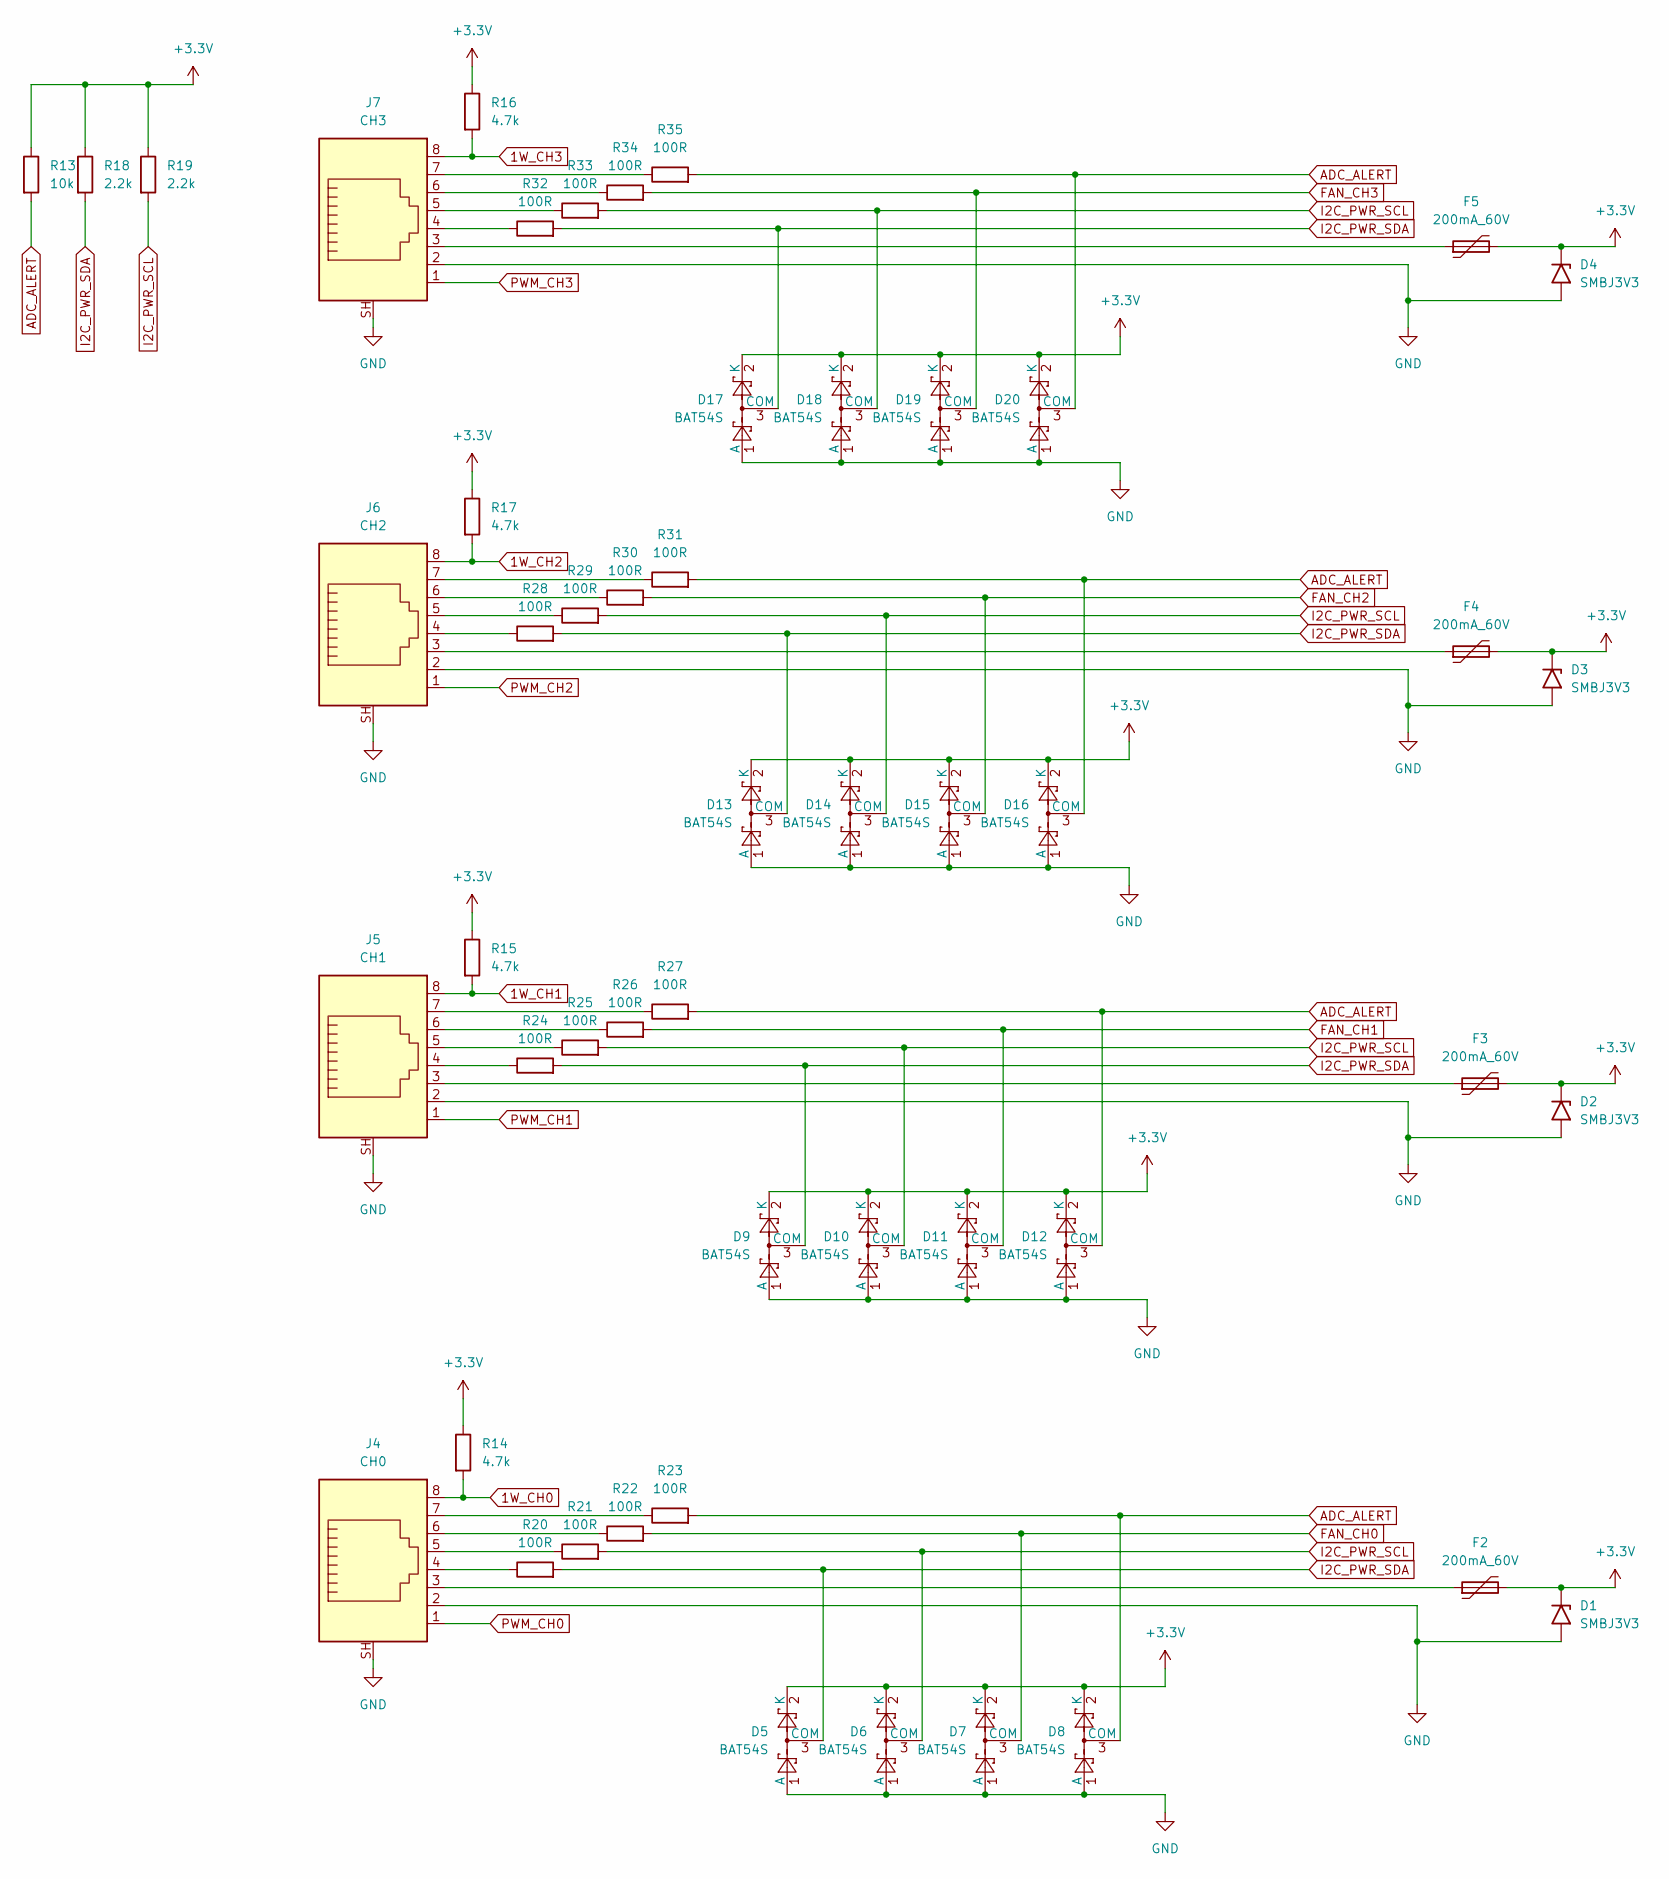
[picture p3: schematic slave_ports.kicad_sch]

Parts:
D1, D2, D3, D4: SMBJ3V3; D_SMB_Handsoldering
D5, D6, D7, D8, D9, D10, D11, D12, D13, D14, D15, D16, D17, D18, D19, D20: BAT54S; SOT-23_Handsoldering
F2, F3, F4, F5: 200mA_60V; Fuse_1206_3216Metric_Pad1.42x1.75mm_HandSolder
J4: CH0; RJ45_Wuerth_7499151120_Horizontal
J5: CH1; RJ45_Wuerth_7499151120_Horizontal
J6: CH2; RJ45_Wuerth_7499151120_Horizontal
J7: CH3; RJ45_Wuerth_7499151120_Horizontal
R13: 10k; R_0805_2012Metric_Pad1.20x1.40mm_HandSolder
R14, R15, R16, R17: 4.7k; R_0805_2012Metric_Pad1.20x1.40mm_HandSolder
R18, R19: 2.2k; R_0805_2012Metric_Pad1.20x1.40mm_HandSolder
R20, R21, R22, R23, R24, R25, R26, R27, R28, R29, R30, R31, R32, R33, R34, R35: 100R; R_0805_2012Metric_Pad1.20x1.40mm_HandSolder

Connections:
1W_CH0: J4.8, R14.2
1W_CH1: J5.8, R15.2
1W_CH2: J6.8, R17.2
1W_CH3: J7.8, R16.2
+3.3V: D1.1 (A1), D2.1 (A1), D3.1 (A1), D4.1 (A1), D5.2 (K), D6.2 (K), D7.2 (K), D8.2 (K), D9.2 (K), D10.2 (K), D11.2 (K), D12.2 (K), D13.2 (K), D14.2 (K), D15.2 (K), D16.2 (K), D17.2 (K), D18.2 (K), D19.2 (K), D20.2 (K), F2.2, F3.2, F4.2, F5.2, R13.1, R14.1, R15.1, R16.1, R17.1, R18.1, R19.1
ADC_ALERT: D8.3 (COM), D12.3 (COM), D16.3 (COM), D20.3 (COM), R13.2, R23.2, R27.2, R31.2, R35.2
FAN_CH0: D7.3 (COM), R22.2
FAN_CH1: D11.3 (COM), R26.2
FAN_CH2: D15.3 (COM), R30.2
FAN_CH3: D19.3 (COM), R34.2
GND: D1.2 (A2), D2.2 (A2), D3.2 (A2), D4.2 (A2), D5.1 (A), D6.1 (A), D7.1 (A), D8.1 (A), D9.1 (A), D10.1 (A), D11.1 (A), D12.1 (A), D13.1 (A), D14.1 (A), D15.1 (A), D16.1 (A), D17.1 (A), D18.1 (A), D19.1 (A), D20.1 (A), J4.2, J4.SH, J5.2, J5.SH, J6.2, J6.SH, J7.2, J7.SH
I2C_PWR_SCL: D6.3 (COM), D10.3 (COM), D14.3 (COM), D18.3 (COM), R19.2, R21.2, R25.2, R29.2, R33.2
I2C_PWR_SDA: D5.3 (COM), D9.3 (COM), D13.3 (COM), D17.3 (COM), R18.2, R20.2, R24.2, R28.2, R32.2
unnamed: F2.1, J4.3
unnamed: F3.1, J5.3
unnamed: F4.1, J6.3
unnamed: F5.1, J7.3
unnamed: J4.4, R20.1
unnamed: J4.5, R21.1
unnamed: J4.6, R22.1
unnamed: J4.7, R23.1
unnamed: J5.4, R24.1
unnamed: J5.5, R25.1
unnamed: J5.6, R26.1
unnamed: J5.7, R27.1
unnamed: J6.4, R28.1
unnamed: J6.5, R29.1
unnamed: J6.6, R30.1
unnamed: J6.7, R31.1
unnamed: J7.4, R32.1
unnamed: J7.5, R33.1
unnamed: J7.6, R34.1
unnamed: J7.7, R35.1
PWM_CH0: J4.1
PWM_CH1: J5.1
PWM_CH2: J6.1
PWM_CH3: J7.1
