dmsolop/esp32-battery-tester/hardware/battery_analyzer_hw/ui_controls.kicad_sch

## KiCad design hardware/battery_analyzer_hw/ui_controls.kicad_sch (2026-11-13, an earlier design)

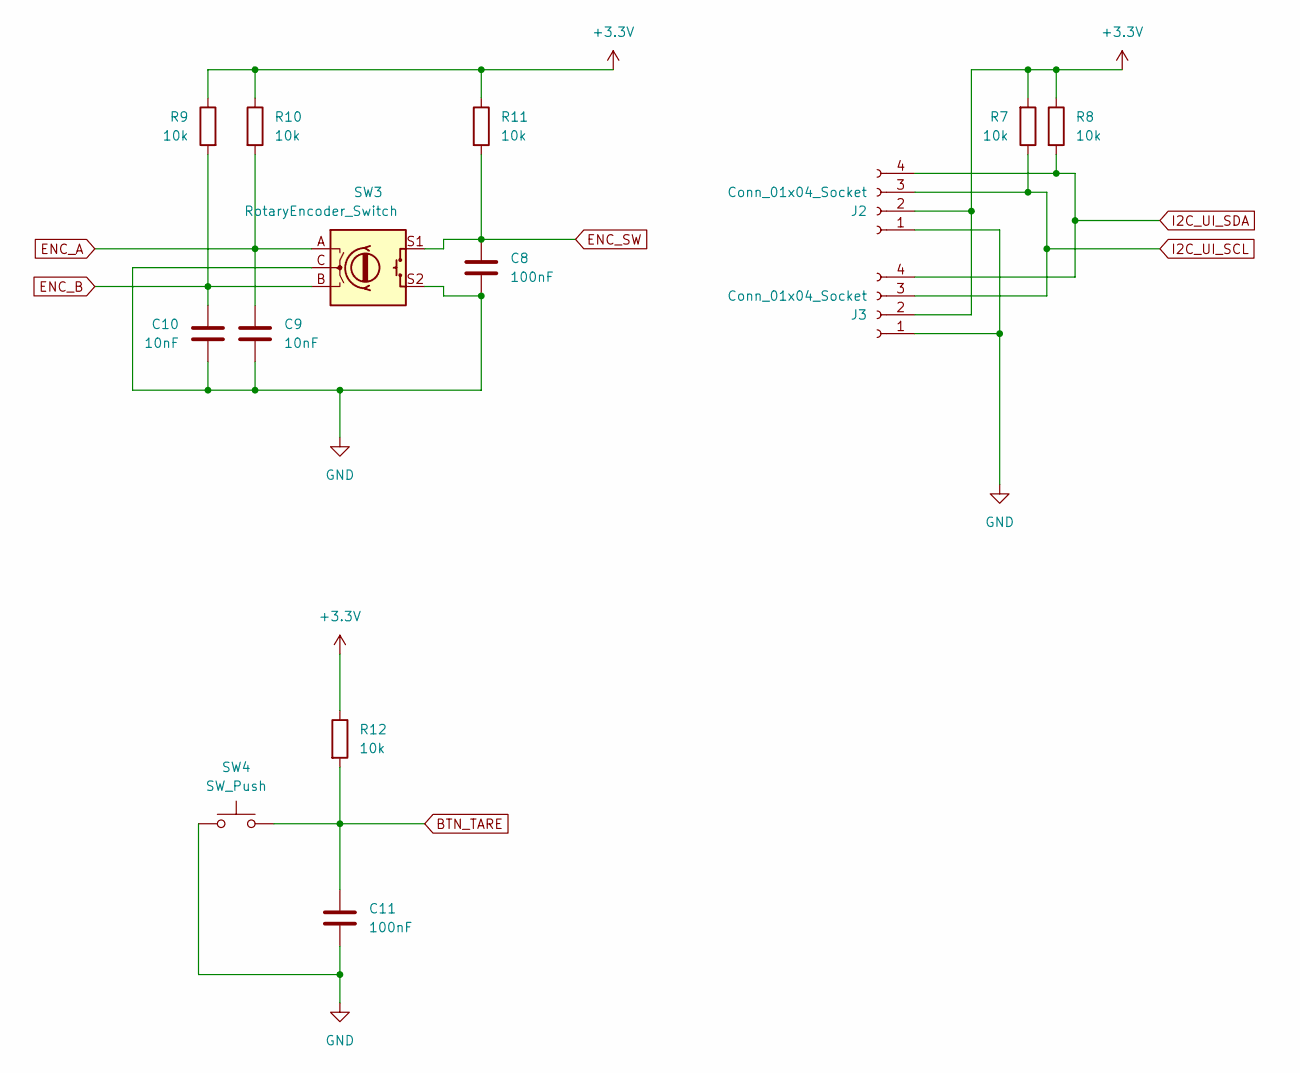
[picture p4: schematic ui_controls.kicad_sch]

Parts:
C8, C11: 100nF; C_0805_2012Metric_Pad1.18x1.45mm_HandSolder
C9, C10: 10nF; C_0805_2012Metric_Pad1.18x1.45mm_HandSolder
J2, J3: Conn_01x04_Socket; PinHeader_1x04_P2.54mm_Vertical
R7, R8, R9, R10, R11, R12: 10k; R_0805_2012Metric_Pad1.20x1.40mm_HandSolder
SW3: RotaryEncoder_Switch; RotaryEncoder_Alps_EC12E-Switch_Vertical_H20mm
SW4: SW_Push; SW_PUSH_6mm

Connections:
+3.3V: J2.2, J3.2, R7.2, R8.1, R9.1, R10.1, R11.1, R12.1
BTN_TARE: C11.1, R12.2, SW4.2
ENC_A: C9.1, R10.2, SW3.A
ENC_B: C10.1, R9.2, SW3.B
ENC_SW: C8.1, R11.2, SW3.S1
GND: C8.2, C9.2, C10.2, C11.2, J2.1, J3.1, SW3.C, SW3.S2, SW4.1
I2C_UI_SCL: J2.3, J3.3, R7.1
I2C_UI_SDA: J2.4, J3.4, R8.2
