dmsolop/esp32-battery-tester/hardware/slave_board/cooling_thermal.kicad_sch

## KiCad design hardware/slave_board/cooling_thermal.kicad_sch (2026-11-13, an earlier design)

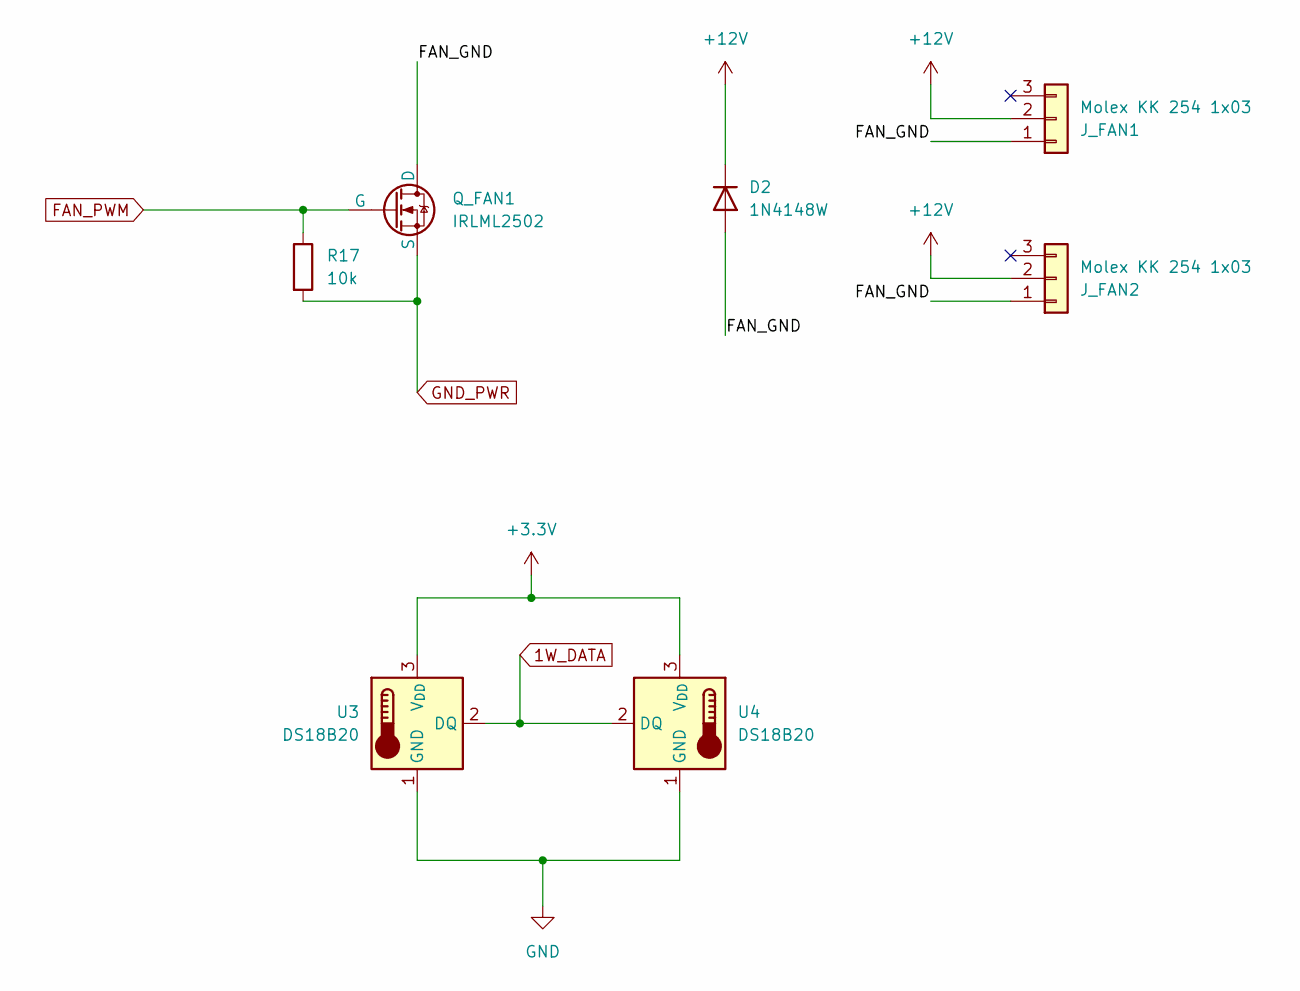
[picture p5: schematic cooling_thermal.kicad_sch]

Parts:
D2: 1N4148W; D_SOD-323
J_FAN1, J_FAN2: Molex KK 254 1x03; Molex_KK-254_AE-6410-03A_1x03_P2.54mm_Vertical
Q_FAN1: IRLML2502; SOT-23
R17: 10k; R_0805_2012Metric_Pad1.20x1.40mm_HandSolder
U3, U4: DS18B20; TO-92_Inline

Connections:
1W_DATA: U3.2 (DQ), U4.2 (DQ)
+3.3V: U3.3 (V_{DD}), U4.3 (V_{DD})
+12V: D2.1 (K), J_FAN1.2, J_FAN2.2
FAN_GND: D2.2 (A), J_FAN1.1, J_FAN2.1, Q_FAN1.1 (D)
FAN_PWM: Q_FAN1.2 (G), R17.1
GND: U3.1 (GND), U4.1 (GND)
GND_PWR: Q_FAN1.3 (S), R17.2
