dmsolop/esp32-battery-tester/hardware/slave_board/power_stage.kicad_sch

## KiCad design hardware/slave_board/power_stage.kicad_sch (2026-11-13, an earlier design)

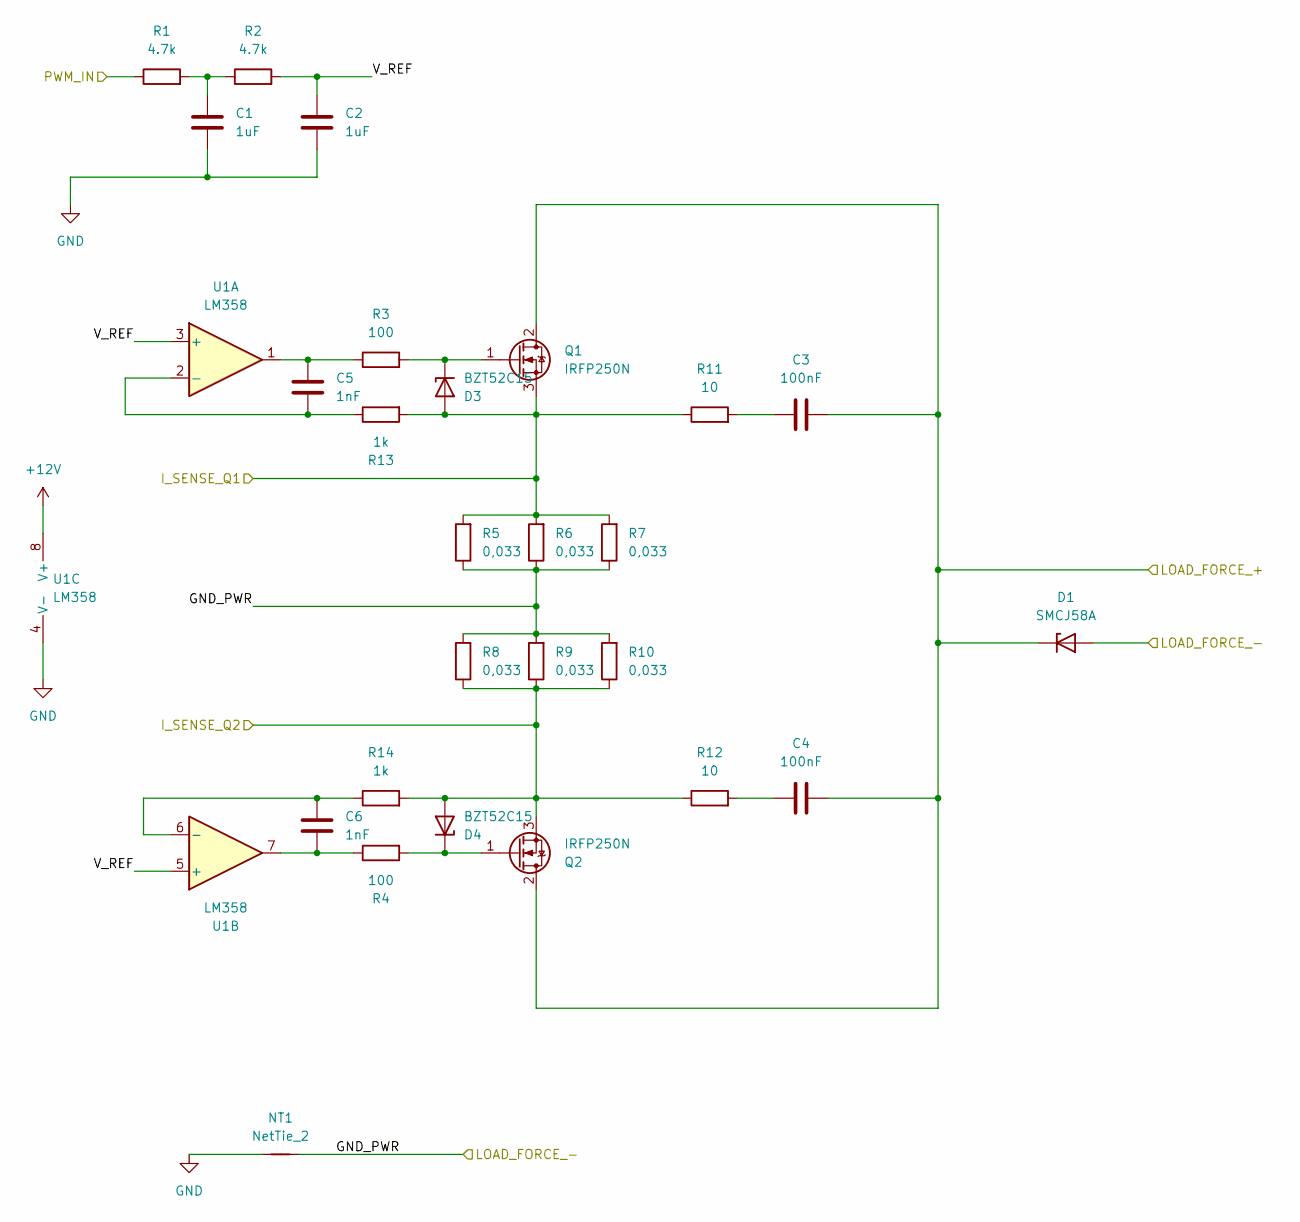
[picture p6: schematic power_stage.kicad_sch]

Parts:
C1, C2: 1uF
C3, C4: 100nF; Nexperia_DSN1608-2_1.6x0.8mm
C5, C6: 1nF; C_0805_2012Metric
D1: SMCJ58A; D_SMC
D3, D4: BZT52C15; D_SOD-123
NT1: NetTie_2; ST_SPBTLE
Q1, Q2: IRFP250N; TO-247-3_Vertical
R1, R2: 4.7k
R3: 100; TO-247-3_Vertical
R4: 100
R5, R6, R7, R8, R9, R10: 0,033; R_2512_6332Metric_Pad1.40x3.35mm_HandSolder
R11, R12: 10; TO-247-3_Vertical
R13, R14: 1k; R_0805_2012Metric
U1: LM358

Connections:
+12V: U1.8 (V+)
GND: C1.2, C2.2, NT1.1, U1.4 (V-)
GND_PWR: D1.2 (A), NT1.2, R5.1, R6.1, R7.1, R8.2, R9.2, R10.2
I_SENSE_Q1: D3.2 (A), Q1.3 (S), R5.2, R6.2, R7.2, R11.1, R13.2
I_SENSE_Q2: D4.2 (A), Q2.3 (S), R8.1, R9.1, R10.1, R12.1, R14.2
LOAD_FORCE_+: C3.2, C4.2, D1.1 (K), Q1.2 (D), Q2.2 (D)
unnamed: C1.1, R1.2, R2.1
unnamed: C3.1, R11.2
unnamed: C4.1, R12.2
unnamed: C5.1, R3.1, U1.1
unnamed: C5.2, R13.1, U1.2 (-)
unnamed: C6.1, R14.1, U1.6 (-)
unnamed: C6.2, R4.1, U1.7
unnamed: D3.1 (K), Q1.1 (G), R3.2
unnamed: D4.1 (K), Q2.1 (G), R4.2
PWM_IN: R1.1
V_REF: C2.1, R2.2, U1.3 (+), U1.5 (+)
