dmsolop/esp32-battery-tester/components/load_control/include/pid_service.h

#pragma once

#include <stdbool.h>

typedef struct
{
    float kp;
    float ki;
    float kd;
    float integral;
    float prev_measured;      // Для Derivative-on-Measurement замість prev_error
    bool prev_measured_valid; // Прапорець ініціалізації першого виміру
    float current_output;     // Поточний рівень виходу ШІМ (позиційна форма)
    float out_min;            // Мінімальний ліміт ШІМ
    float out_max;            // Максимальний ліміт ШІМ
} pid_context_t;

// Ініціалізація контексту регулятора із заданими коефіцієнтами та лімітами
void pid_service_init(pid_context_t *ctx, float kp, float ki, float kd, float out_min, float out_max);

// Миттєве скидання накопиченої помилки та обнулення виходу ШІМ
void pid_service_reset(pid_context_t *ctx);

// Головна функція розрахунку. Повертає готове значення керуючого впливу (позиційна форма P + I + D)
float pid_service_compute(pid_context_t *ctx, float setpoint, float measured_value, float dt_sec);
