dmsolop/esp32-battery-tester/components/display_engine/include/icons.h

#pragma once
#include <stdint.h>

// Значок WiFi (8x8 пікселів). Кожен байт — горизонтальний рядок.
// 1 = піксель світиться, 0 = погашений.
static const uint8_t icon_wifi_8x8[8] = {
    0x3C, //   ####
    0x66, //  ##  ##
    0xC3, // ##    ##
    0x00, //
    0x3C, //   ####
    0x66, //  ##  ##
    0x00, //
    0x18  //    ##
};
