dmsolop/esp32-battery-tester/(commit log)

2026-09-13 Implement load control PID task
2026-09-13 Fix component initialization in main
    [main.c]
2026-09-14 Add I2C and ADC driver boilerplate with mutex
2026-09-14 Migrate I2C driver to new i2c_master API
2026-09-14 Fix CMake dependency for new I2C master driver
2026-09-14 Register ADS1115 device on I2C bus
2026-09-14 Implement ADS1115 I2C read logic
2026-09-15 Integrate ADC reads and emergency abort in load_control
2026-09-16 Fix capacity math and implement STATE_PRE_CHECK logic
    [load_control.c]
2026-09-20 implement ds18b20 driver with match rom and conversion
2026-09-20 refactor: replace single temperature variable with sensor array
2026-09-20 feat: add NiMH battery role to sensor types
2026-09-21 implement ledc pwm driver for hardware v_ref generation
2026-09-21 integrate PID control and hardware PWM into load control loop
2026-09-21 refactor: extract PID math into independent pid_service component
2026-09-21 refactor: extract capacity integration math into independent integration_service
2026-09-23 feat: add Dallas CRC8 validation to DS18B20 sensor driver
2026-09-23 feat: implement non-blocking DS18B20 temp_service using FreeRTOS timers
2026-09-23 refactor: use channel_metrics_t as SSOT for temp sensors
2026-09-24 fix: replace linear PWM pin math with Kconfig static array
    [load_control.c]
2026-09-24 feat(pwm): add IRAM_ATTR hardware bypass function for emergency stop
2026-09-24 feat(adc): migrate pins to Kconfig and implement ALERT hardware interrupt
2026-09-24 refactor(safety): replace blocking delay with RTOS notification and register ADC alert task
2026-09-24 refactor(temp): decouple global 1-Wire bus state from per-channel reading logic in safety monitor
2026-09-25 build: migrate target to esp32s3, update Kconfig with P2 safe pins, set OpenOCD to builtin USB-JTAG
2026-09-26 feat: add dual OLED I2C init and bus scanner
2026-09-26 fix: add missing scl_speed_hz to oled i2c config
    [ui_interface.c]
2026-09-26 feat: implement independent framebuffers for dual oled screens
2026-09-29 fix: swap screen i2c addresses and apply hardware 180-degree rotation
    [ui_interface.c]
2026-09-29 fix: restore full i2c and lcd hardware initialization in display engine
    [display_engine.c]
2026-09-29 feat: implement pcnt encoder driver and master-detail ui state machine
2026-09-29 feat(state): add core battery test settings and PRO config structs
2026-09-30 feat(adc): implement Ohm's law and zero offset calibration
2026-09-30 feat(ui): add data binding with NDEBUG debug stubs, add channel detail, settings menu, and START action
    [ui_interface.c]
2026-09-30 feat(load): read target current and cutoff voltage from settings
2026-09-30 fix: prevent integer overflow in adc current calculation
    [adc_driver.c]
2026-09-30 feat: separate raw pid current from clamped display metrics
2026-09-30 fix: implement fixed 100hz pid loop and non-blocking notifications
    [load_control.c]
2026-09-30 fix: add voltage hysteresis to pre-check against recovery bounce
    [load_control.c]
2026-09-30 Part of fixing PID
2026-09-30 refactor: upgrade pid service to time-aware algorithm
2026-09-30 refactor: simplify sensor roles and remove NDEBUG stubs from UI feat: implement NVS chemistry storage and default settings matrix
2026-10-05 feat: independent 1-wire buses and hardware auto-routing setup
2026-10-06 feat: implement autonomous self-test state with zero-offset and power path validation
2026-10-06 feat: implement UI event messaging and error acknowledge mechanism
    [ui_interface.c]
2026-10-07 chore(hw): init KiCad 10 project for ESP32-S3 DevKit shield
    [battery_analyzer_hw.kicad_pcb, battery_analyzer_hw.kicad_sch]
2026-10-07 feat(hw): add USB-C with native JTAG and AMS1117-3.3 power block
    [battery_analyzer_hw.kicad_sch]
2026-10-07 feat(hw): add ESP32-S3 core, strapping pins and boot logic
    [battery_analyzer_hw.kicad_sch, mcu_core.kicad_sch]
2026-10-07 feat(hw): add UI sheet with dual OLEDs, encoder and button
    [battery_analyzer_hw.kicad_sch, ui_controls.kicad_sch]
2026-10-07 feat(hw): add RJ45 slave ports, isolated 1-Wire and PWM routing fix(hw): split I2C into UI and PWR buses to prevent PID blocking
    [battery_analyzer_hw.kicad_sch, mcu_core.kicad_sch, slave_ports.kicad_sch, ui_controls.kicad_sch]
2026-10-09 refactor(hw): upgrade RJ45 to shielded, repurpose pin 1 for fan PWM fix(hw): optimize RJ45 pinout for T568B twisted pairs
    [mcu_core.kicad_sch, slave_ports.kicad_sch]
2026-10-10 chore(hw): init new KiCad project for slave power module
    [slave_board.kicad_pcb, slave_board.kicad_sch]
2026-10-10 feat(hw): complete Root and Power_Stage schematic routing
    [power_stage.kicad_sch, slave_board.kicad_sch, telemetry.kicad_sch]
2026-10-12 feat(hw): complete Telemetry schematic, ADS1115 integration and voltage divider
2026-10-13 feat(hw): add Master-board RJ45 protection circuit with PTC and BAT54S clamps
2026-10-13 hw(master): fix footprints, apply HandSolder and Tantalum
2026-10-14 hw(slave): fix footprints, enforce HandSolder, defer connector selection
2026-10-15 Implement cooling sheet, fan control, and update power connectors
2026-10-15 Fix: Convert local net labels to global in master board
2026-10-20 feat(agents): define 9 specialized AI agent prompts for core engineering workflows including system architecture, hardware, HAL drivers, PID control, safety, display UI, 3D enclosure, and documentati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
2026-10-24 feat: add chief-engineer-planner skill for strategic brainstorming, risk evaluation, and cross-domain traceability
2026-10-24 feat: add specialized custom modes for PCB, CAD, firmware, and lab testing workflows
2026-10-24 feat: add hal-driver-specialist skill for i2c adc and non-blocking 1-wire ds18b20 integration
2026-10-24 feat: add kicad-hardware-engineer skill with strict routing rules, kelvin sensing, and component constraints. refactor: update kicad skill to dynamically scan docs directory for inventory and referen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
2026-10-24 feat: add load-control-engineer skill with time-aware pid, 64-bit micro-math, and dcir pulse logic
2026-10-24 feat: add mechanical-engineer skill with bambu lab 3d printing tolerances and thermal airflow rules
2026-10-24 feat: add system-architect skill with strict ssot traceability and explicit file referencing
2026-10-24 feat: add ui-ux-developer skill for dual oled imgui pipeline and pcnt encoder management
2026-10-25 docs: enhance doc_style_rules.md with FSM integration, error handling, strict traceability, and 20-word commit limits
2026-10-25 docs: expand hal_driver_rules.md with PGA limits, I2C mutex rules, and hardware alert integration
2026-10-25 docs: revise pid_math_rules.md adding derivative on measurement, dynamic anti-windup, and pure integer capacity math
2026-10-25 docs: update safety_fault_rules.md with 30A/60V limits, buzzer alarm integration, and strict fault latching
2026-10-25 docs: initialize ui_ux_rules.md detailing dual OLED pipeline, PCNT filtering, passive UI observer rules, and buzzer UX
2026-10-25 docs: add kicad_pcb_rules.md enforcing European notation, Kelvin sensing, star ground, and 140W thermal trace design
2026-10-25 docs: update CAD/Mechanics custom mode instructions with handoff protocol and skill dependency
2026-10-25 docs: update Hardware/PCB custom mode instructions with handoff protocol and skill dependency
2026-11-03 Fix. Changed labels of chennals i2c
2026-11-03 Fix. Changed mosfets and some other things
2026-11-03 docs(hw): sync I2C pinout and verify netlists for breadboard prototyping
2026-11-05 git commit -m "hardware: verify battery analyzer netlist against unified pinout variant b"
2026-11-07 test(lab): validate breadboard power stage, identify pid filter phase lag
2026-11-07 docs(arch): approve passive PWM LPF B2, positional PID, and 5mOhm shunts
2026-11-07 feat(adc): add dual channel sensing and 64bit integer current math
2026-11-07 feat(load_control): switch to 12bit 20kHz PWM and positional PID with anti-windup
2026-11-07 feat(ui): add interactive encoder parameter editing in settings menu
2026-11-08 fix(load_control): prevent pid task from overwriting raw_pwm engineering mode
2026-11-08 docs: record stage 3 lab blockers and peripheral test tickets
2026-11-08 feat(ui): add windowed scrolling, start/stop toggle, and persistent chem switch
2026-11-08 feat(ui): add safety settings limits and test diag menu with raw pwm
2026-11-08 Всі інженерні вимоги Кроку 4 успішно реалізовано згідно зі специфікацією [`docs/project_spec.md`](docs/project_spec.md:1) без виконання заборонених операцій (компіляція та git не запускалися):
    1. **Драйвер DS18B20 та підтримка 3 датчиків на канал:**
    - У [`components/temp_sensor/ds18b20.c`](components/temp_sensor/ds18b20.c:86) та [`components/temp_sensor/include/ds18b20.h`](components/temp_sensor/include/ds18b20.h:17) додано функції [`ds18b20_write_scratchpad()`](components/temp_sensor/ds18b20.c:86) і [`ds18b20_copy_scratchp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
2026-11-09 feat(ui): add interactive DS18B20 sensor role binding menu with eeprom save
2026-11-09 fix(ui): increase sensor bind title buffer to prevent format truncation warning
2026-11-10 feat(ctrl,buzzer,adc): implement 4-wire DCIR pulse pool and fix buzzer clamp
2026-11-11 feat(load_control): isolate fan pwm to ledc timer 1 at 30hz
2026-11-11 feat: add fan kickstart, min duty map, and full ui audio feedback
2026-11-13 feat(hw): add SMD piezo buzzer KLS3-SMT with discharge resistor on IO42
2026-11-13 Current fixing
2026-11-13 docs: finalize hardware freeze audit and register schematic tickets for pcb
2026-11-13 hw: complete pre-pcb schematic freeze audit and pinout verification
